cvonk/OPNhydroponics/hardware/ARCHITECTURE.md

# OPNhydroponics - Hardware Architecture

## System Overview

The **OPNhydro** project is a sophisticated **ESP32-C6 based controller** designed for a 50-plant Nutrient Film Technique (NFT) system, prioritizing chemical stability, precision dosing, and robust safety interlocks.

The architecture is built around a **24V power rail**, which was chosen specifically to accommodate a wide variety of main circulation pumps and solenoid valves.

### Reservoir and Chemical Stability
   The system centers on a **120L reservoir** (with a 100L operating level), which serves as a vital chemical and thermal buffer.
   - **PID Stability:** The 100L volume provides "chemical inertia," acting as a low-pass filter so that small doses from the pumps do not cause erratic sensor readings or "jittery" PID responses.
   - **Mixing Ratio:** The design aims for a "sweet spot" in the mixing ratio (the relationship between total volume and dose volume) to ensure sensors detect changes without causing the system to become unstable or oscillate.
   - **Rule of Thumb:** The selection of 100L for 50 plants follows the guideline of 2L of buffering per plant for leafy greens.

### Precision Dosing Strategy

For nutrient and pH management, the project utilizes ANKO A200SX stepper-based peristaltic pumps rather than standard brushed DC pumps.
   - **Precision:** Stepper motors provide highly accurate delivery (down to µL ranges), which is essential because a 100L reservoir of soft water may only require **0.2 mL of acid** to shift the pH by 0.1 points.
   - **EMI Mitigation:** To protect sensitive pH and EC probes from electrical noise (EMI) generated by the stepper drivers, the system employs a **"Silent Read"** strategy, where the motor drivers are disabled before the microcontroller requests data from the sensors.
   - **Driver Configuration:** The **Trinamic TMC2209** drivers were selected to handle the 1.7A current required by the ANKO pumps, with plans to limit current in firmware to 60–70% of the motor's rating to further reduce EMI and heat.

### Sensor Suite and Isolation

The system uses industry-grade probes to ensure long-term reliability in harsh, mineral-heavy environments.
   - **Probe Selection:** **BlueLab PROBPH** and **PROBPCEC** probes were selected for their ability to handle 24/7 immersion
. The pH probe features a **double junction**, providing a physical barrier that prevents nutrient salts from "poisoning" the internal reference wire.
   - **Ground Loop Prevention:** Because multiple probes in conductive water can distort each other's readings, the system uses **Isolated I2C** via the **ADM3260** chip. This provides a physical air gap to eliminate ground loops.
   - **Level Sensing:** A **LiDAR** sensor provides continuous depth monitoring, while **mechanical float switches** act as hardware failsafes to prevent the pump from running dry or the reservoir from overfilling   

### System Logic and Connectivity

The **ESP32-C6** was chosen for its modern connectivity options.
   - **Standalone Reliability:** While integrated with Home Assistant and (Matter/Thread in the future), the controller remains autonomous, performing daily pH corrections (specifically at 10:00 AM to avoid temperature-induced fluctuations) and EC checks every 10 minutes.
   - **Fail-Safe Design:** The Auto Top-Off (ATO) system uses a normally closed (NC) solenoid valve, ensuring the water supply shuts off if power is lost. Float switches protect the main motor from running dry, and the reservoir from overflowing.

```
┌─────────────────────────────────────────────────────────────┐
│                           24V DC INPUT                      │
│                               │                             │
│                    ┌──────────┴──────────┐                  │
│                    │                     │                  │
│                    ▼                     ▼                  │
│              ┌─────────┐           ┌─────────┐              │
│              │ 24V Bus │           │ 5V DC   │              │
│              │ (Pumps) │           │ (Logic) │              │
│              └────┬────┘           └────┬────┘              │
│                   │                     │                   │
│         ┌─────────┼─────────┐           ▼                   │
│         ▼         ▼         ▼        ┌──────────┐           │
│   ┌──────────┐ ┌──────────┐ ┌─────┐  │ 3.3V LDO │           │
│   │Main Pump │ │ Dosing   │ │ ATO │  └────┬─────┘           │
│   │ MOSFET   │ │ Stepper  │ │Valve│       │                 │
│   └──────────┘ └──────────┘ └─────┘       │                 │
│                                    ┌──────┴──────┐          │
│                                    │  ESP32-C6   │          │
│                                    │             │          │
│                                    └──────┬──────┘          │
│                                           │                 │
│         ┌─────────────┬────────────┬──────┴──────┐          │
│         │             │            │             │          │
│    ┌────┴────┐   ┌────┴────┐   ┌───┴───┐  ┌──────┴──────┐   │
│    │  I2C    │   │  GPIO   │   │ UART  │  │    RS-485   │   │
│    │  Bus    │   │         │   │       │  │   (future)  │   │
│    └────┬────┘   └────┬────┘   └───────┘  └─────────────┘   │
│         │             │                                     │
│    ┌────┴───────┐  ┌──┴─────────────┐                       │
│    │ pH EZO     │  │ LiDAR          │                       │
│    │ EC EZO     │  │ Float switches │                       │
│    │ RTD EZO    │  └────────────────┘                       │
│    └────────────┘                                           │
└─────────────────────────────────────────────────────────────┘
```

### Selected Hardware Components

The system uses industrial-grade components to ensure reliability in a continuous hydroponic environment.

Component | Selected Part | Key Reason for Selection
----------|---------------|-------------------------
Microcontroller | ESP32-C6-DevKitC-1-N8 | Integrated USB-C, PCB antenna, and support for Matter/Thread.
Main Pump | SHYSKY DC40F-2470 | 24V brushless motor, 30,000-hour lifespan, and weak acid/alkaline resistance.
Dosing Pumps | ANKO A200SX | Stepper-based for precision (µL range) and high torque.
Stepper Drivers | Trinamic TMC2209 | Supports 2.0A RMS current and offers near-silent operation.
pH Probe | BlueLab PROBPH | Double junction prevents reference poisoning; no fragile glass bulb.
EC Probe | BlueLab PROBPCEC | Easier to clean than laboratory cavity-style designs.
Temp Probe | Atlas Scientific PT-1000 | Long lifespan and direct I2C interface via EZO-RTD.
Isolation Chip | ADM3260 | Provides a physical air gap to eliminate ground loops between probes.
Reservoir Level Sensor | Benewake TF-Luna | LiDAR technology stays dry and requires no maintenance.
Float Switch | Flowline LH25-1101 | Mechanical reed switch acts as an industrial-grade hardware failsafe.
ATO Valve | DIGITEN DC 24V NC | Normally Closed (NC) design ensures it fails safe (closed) if power is lost.

## Design Decisions

Designing for a 50 leafy greens / herbs system.

A 24V rail is used because it enables a broader selection of main circulation pumps and ATO solenoid valves, which are voltage-sensitive (unlike current-regulated stepper drivers).

The controller operates independently when Home Assistant is unavailable:
- Local pH control: Once daily at 10:00 AM (avoids temperature-induced pH fluctuations)
- Doses pH Down only — pH creep is always upward; no pH Up pump fitted
- Local EC control: Doses nutrients when EC drops below threshold (every 10 min)
- Safety interlocks: Float switch protection always active
- ATO: Requires HA for user confirmation (manual override via physical button possible)
- Data logging: Buffers readings until HA reconnects

---

### 1. Main Pump Selection

Requirements:
- 400-600 L/hr for NFT (Nutrient Film Technique)
- 24V brushless motor for longlivity
- 2.5m head

#### 1.1. Parts Considered

Feature        | ✅[SHYSKY/AUBIG DC40F-2470](https://www.amazon.com/SHYSKY-DC40F-2460-Brushless-Waterproof-Submersible/dp/B0C5721V85) | [Topsflo TL-B10](https://www.topsflo.com/brushless-dc-pump/tl-b10-brushless-dc-pump.html) |
---------------|--------------|---------------------|
Voltage        | 24V DC       | 24V                 |
Current        | 1.2A         | 1.3A                |
Max Head       | 6m           | 8m                  |
Max Flow       | 960 L/hr     | 720 L/hr            |
Lifespan       | 30,000 hr    | 20,000 hr           |
Materials      | Weak acid/alkaline | FDA approved  |
Noise          | <40dB        | <40dB               |
Self-Priming   | No           | No                  |
Variable speed | PWM          | PWM                 |
Cost           | \$26         | \$30 on AliExpress  |

**✅Selected: SHYSKY/AUBIG DC40F-2470** for free shipping with Amazon Prime.

---

### 2. Main Reservoir Selection

In a Nutrient Film Technique (NFT) system, the reservoir acts as nutrient bank for the entire closed-loop operation. Since we're are building a PID-controlled system, the reservoir’s most critical function is providing chemical and thermal buffering to ensure your sensors and pumps have a stable environment to work within. 

#### 2.1. Functions of the Reservoir

- **Chemical Buffering:**: A larger reservoir volume acts as a buffer against rapid pH and EC fluctuations. For the PID loop this is vital; a small reservoir would cause "jittery" sensor readings, making it difficult for your system to learn gain without overshooting.
- **Thermal Stability:** Water has a high heat capacity, so the reservoir helps regulate the temperature of the nutrient solution. This protects roots from rapid temperature swings that could lead to stress or dissolved oxygen issues.
- **Recirculation & Filtration Point:** It serves as the collection point where gravity returns the nutrient film from the channels. This is where you place filters to prevent debris from reaching your pumps and air stones to maintain high dissolved oxygen levels.
- **Sensor Hub:** In an automated system, the reservoir is the ideal location for your pH and EC probes. It provides a "mixed" sample of the entire system's chemistry, ensuring your PID loop makes decisions based on the average state of the solution rather than localized channel data.

#### 2.2. Requirements

- **PID Stability:** A 100L+ volume provides enough chemical inertia so that a 1 mL dose from your stepper pump doesn't cause a massive pH spike. This makes your Integral (I) tuning much easier to stabilize. It acts as a Low-Pass Filter for your chemical concentrations.
- **Evapotranspiration:** On a hot day, 50 mature plants can easily drink 10–15 liters. A 100L reservoir ensures we're not refilling every 24 hours.
- **Drain-Back capacity:** In an NFT system, when the pump stops, the "film" in the channels drains back. You need roughly 15-20% extra headspace in the tank to catch this water without an overflow.
- **Light proofing:** the reservoir must be fully opaque. Any light penetration drives algae growth, which consumes nutrients, clogs the system, and destabilises pH. Black HDPE tanks or IBC totes with an opaque cover are preferred.
- **Tight fit:** use a tight-fitting lid at all times to reduces evaporation (slowing EC drift), blocks ambient light, and prevents insects, and debris from entering the solution. Keep cutouts for plumbing and sensor cables small as practical and sealed.

#### 2.3 Rule of Thumb

The **Rule of Thumb** is that Leafy greens (lettuce, herbs, kale) typically require **1.5 to 2 liters (0.5 gallons) of buffering per plant**.  Fruiting crops (tomatoes, peppers) will need about twice that. The rationale is that fruiting crops have higher and more variable water and nutrient uptake, so a larger buffer per plant is needed to prevent rapid EC and pH swings between dosing events.

Type of crop | Buffering per plant | Buffering for 50 plants
-----|-----------|--------------
Leafy greens (lettuce, herbs, kale) | 2 L/plant | 100 L
Fruiting crops (tomatoes, peppers)  | 4 L/plant | 200 L

**✅Selected: 120L Black Reservoir**, with an operating level of 100 liters, so it leaves room for drain-back. 

Metric           | Recommendation
-----------------|---------------
Total Volume     | 120 Liters (Standard heavy-duty tote size)
Operating Level  | 100 Liters (Leaves room for drain-back)
Daily Water Loss | ~10% (10 Liters/day during peak growth)
Mixing Ratio     | 100:1 (Ideal for 1mL/min to 100mL/min pump range)

#### 2.4. Mixing Ratio

The **Mixing Ratio** refers to the relationship between the total reservoir volume and the maximum volume of a single dosing event. This ratio is the "sweet spot" for ensuring that your sensors can detect a change without the system becoming chemically unstable or "oscillating".
- **High Ratio (e.g., 500:1):** Very stable, but slow to correct.
- **Low Ratio (e.g., 20:1):** Very fast, but high risk of "jitter".

---

### 3. Main Reservoir Level System

Tight water level control is less about volume and more about chemical stability.
- When **water evaporates**, it leaves behind minerals, salts, and nutrients. This can lead to osmotic shock, nutrient burn in plants. An Auto Top-Off (ATO) keeps the ratio of water-to-solids constant.
- Smaller volumes of water are more susceptible to rapid **pH swings**. Maintaining a consistent reservoir volume provides a larger "thermal and chemical mass," which acts as a buffer against rapid fluctuations caused by plant uptake or waste breakdown.
- Most pumps are not designed to **run dry**.

Requirements:
- **User confirmation**: System requests approval from user before filling
- **Timeout**: Maximum fill time prevents overflow if sensor fails
- **Safety**: Float switches provides hardware backup cutoff
- **Valve type**: 24V NC (normally closed) solenoid - fails safe (closed)
- **Hysteresis** in driving the OTA valve. If you triggered a refill the second the water dropped 1mm, your pump would "chatter" (rapidly flip on/off).

Purpose:
- A **continuous depth sensor** measure the liquid height to track consumption and guide the automatic top-off (ATO) feature
- Independent sensors for **high and low alarms** provide a safety feature in case the ATO system fails. The high alarm disables the auto top-off feature.  The low alarm disables the main pump so it can't run dry.

#### 3.1 Continuous Depth Sensor Selection

This sensors provide a real-time measurement of the liquid height, which is ideal for tracking consumption and guiding the auto top-off feature.

##### Technologies Considered

Feature  | LiDAR | Capacitive | Ultrasonic | Hydrostatic
---------|-------|------------|------------|------------
Contact | Non-contact | ❌Contact | Non-contact | ❌Contact
Precision | Very High (mm) | High (±0.2%) | Moderate (±0.25") | High (±0.1%)
Foam/Vapor | Unaffected | Unaffected | Poor | Unaffected
Blind Spot | 10 cm | 0 cm | ❌20 cm | 0 cm
Best For | Clean liquids | Viscous/Sticky fluids | General water/Chemicals | Deep tanks/Turbulence
Example Product | Benewake TF-Luna | uFire Capacitive | JSN-SR04T | DFRobot Gravity
Interface | I2C/UART | I2C | GPIO | ❌Analog
Approx. Price | \$25 – \$40 | \$35 – \$50 | \$10 – \$15 | ❌\$60 – \$80

**✅Selected: LiDAR** since it stays dry, so no maintenance-free. The 10 cm head room is acceptable since it only needs to measure the level up to the high alarm float sensor. Capacitance and hydro static were rejected since mineral buildup eventually affects these sensors.  Ultrasonic is rejected, since it needs excessive head room.

##### Parts Considered

Feature         | ST VL53L1X<sup>[1](https://www.adafruit.com/product/3967)</sup> | Benewake TF-Luna<sup>[2](https://www.robotshop.com/products/benewake-tf-luna-8m-lidar-distance-sensor)</sup> | Benewake TFmini-S<sup>[3](https://www.robotshop.com/products/benewake-tfmini-s-micro-lidar-module-i2c-12m)</sup>
----------------|------------------|------------------|------------------
Range           | 0.04-4 m         | 0.1-8 m          | 0.1-12 m
Interface       | I2C              | I2C/UART         | I2C/UART
Supply Voltage  | 2.6V – 5.5V      | 3.7V – 5.2V      | 4.5V – 6.0V
I/O Logic Level | 3.3V / 5V        | 3.3V             | 3.3V
Form Factor     | ❌Breakout board | Compact module   | Ruggedized module
Price           | $14.95           | $22.26           | ❌$48.10

**✅Selected: Benewake TF-Luna** because if its housing and price.  Rejected the ST VL53L1X since it is an unhoused breakout board.  Rejected the Benewake TFmini-S because if its price.

#### 3.2 High/Low Alarm Sensor Selection

Goals:
- A low level float switch keeps keep main pump from running dry.
- A high level float switches provides a hardware guard against both overfilling the reservoir.

Requirements
- The switches should disable the driving of the MOSFETs that control the ATO feature and main pump.
- A normally closed switch is less likely to fail.
- Horizontal side-mount, so the top of the reservoir can be opened for inspection. Also the sensing level is fixed by where you drill the hole — no float travel calculation, no ambiguity. 

##### Parts Considered

Feature                 | ✅[Flowline LH25-1101](https://www.flowline.com/product/switch-tek-lv20-lh25-mini-float-level-switch/) | [XKC-Y25-NPN](https://naylampmechatronics.com/img/cms/000435/datasheet_XKC-Y25-V.pdf) | [Gravity Digital (SEN0204)](https://mm.digikey.com/Volume0/opasdata/d220001/medias/docus/2264/SEN0204_Web.pdf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)
------------------------|--------------------------|--------------------------|--------------------------
Technology              | Mechanical Float (Reed)  | Capacitive (Non-contact) | Capacitive (Non-contact)
Material                | Polypropylene            | ABS Plastic              | ABS Plastic
Mount                   | 1/2" NPT Hole            | External Adhesive        | External Adhesive
Accuracy                | ±5mm                     | ±3mm                     | ±3mm
IP-Rating               | IP68 (Submersible)       | IP67 (Water resistant)   | IP67 (Water resistant)
Max Wall Thickness      | None                     | ~13mm                    | ~13mm
Sensitivity to Splashes | Moderate                 | ❌High                   | ❌High
Price                   | ~$40                     | ~$11                     | ~$13

**✅Selected: Flowline LH25-1101** is the "industrial" choice. Since the main reservoir is prone to splashing, a physical float is less likely to give a false positive from condensation on the tank walls. Use a stilling well (a simple piece of 2" PVC pipe with small holes at the bottom) to surround the float and keep the water surface calm

#### 3.3 Automatic Top-Off (ATO) Selection

Requirements
- 24V to match system power rail
- Normally Closed (NC), so it is fail-safe: valve closes on power loss
- 0-0.8 MPa (0-116 PSI), the typical municipal water pressure
- Brass body, EPDM/NBR seal, so it is food-safe and corrosion resistant

##### Parts Considered

Feature | ✅[DIGITEN DC 24V 1/4" NC](https://www.amazon.com/DIGITEN-Solenoid-Reverse-Osmosis-System/dp/B00X6RAHMU) | [US Solid JFSV00068](https://ussolid.com/products/u-s-solid-electric-solenoid-valve-1-4-24v-dc-solenoid-valve-stainless-steel-body-normally-closed-viton-seal-html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) | [US Solid MSV00027](https://ussolid.com/products/u-s-solid-motorized-ball-valve-1-4-stainless-steel-electrical-ball-valve-with-full-port-9-24-v-ac-dc-2-wire-auto-return-html)
----------------|-------------------------|-------------------|--------------------
Voltage         | 24V DC                  | 24V DC            | 9-24V AC/DC
Body            | Plastic                 | Stainless steel   | Stainless steel
Default state   | Normally Closed         | Normally Closed   | Normally Closed
Port            | 1/4" Quick Connect      | 1/4" NPT thread   | 1/4" NPT thread
Current         | 0.2A                    | 0.6A              | 0.2A (when moving)
Max pressure    | 0.8 MPa (116 PSI)       | 0.7 MPa (101 PSI) | 1.0 MPa (145 PSI)
Design          | Solonoid orifice        | Solonoid orifice  | Ball valve
Response time   | <1s                     | <1s               | 3-5s
Drinking safe   | Yes                     | Yes               | Yes
Cost            | \$10                    | \$30              | $25

**✅Selected: DIGITEN DC 24V 1/4" NC** for its price.

---

### 4. Dosing Pump Selection

In this NFT (Nutrient Film Technique) system, the dosing pumps act as the "precision injectors" of the system. Their primary function is to maintain a stable chemical environment.

Use a peristaltic pumps for their characteristics
- **Same volume per revolution** independent how much is left in the supply bottle. 
- **Self-priming** capability
- **Chemical resistance** (no wetted metal parts)
- **Self-sealing** when stopped (rollers pinch tube; no drip-back)

Unlike a standard water pump, a peristaltic pump is positive displacement. Whether the pH down or nutrient bottles are full or nearly empty, the pump delivers the exact same volume per revolution. This makes the "gain learning" of a  PID control algorithm much more accurate.

Requirements:
1. **Micro-Dosing pH Down**: In this recirculating NFT system, the reservoir volume is small relative to the flow. To avoid "pH Yo-yoing," the pump must deliver tiny increments of acid.
2. **Dynamic Nutrient Delivery**: When plants have "eaten" the nutrients, the EC (Electrical Conductivity) drops. The pump needs to ramp up speed to restore concentration quickly. 

#### 4.1. Requirements

Before we can explore dosing pumps, we need to know the required dosing.

In an active NFT or DWC system, pH creeps upward between doses due to two mechanisms:

1. **Plant nutrient uptake**: roots preferentially absorb nitrate (NO₃⁻) and release bicarbonate (HCO₃⁻) in exchange, alkalising the solution over hours.
2. **CO₂ offgassing**: carbonic acid (H₂CO₃) from dissolved CO₂ escapes the reservoir, removing a natural acid buffer and allowing pH to rise.

This upward drift is the dominant long-term trend in a healthy system.

##### Initial Makeup

Filling the reservoir with municipal water.

Assumptions:
- Reservoir size: 100L
- Municipal tap water at pH 7.0 to 8.5
- Nutrient: AmHydro Lettuce Nutrients, dosed at 4.0 mL/L per nutriant.
- Nutrients at pH 2.0 - 4.0
- pH Up Concentration: 25–30% Potassium Hydroxide.
- pH Down Concentration: 10% Phosphoric Acid.

**AmHydro Lettuce Nutrients** need to be mixed at 4 mL/L of water. For a 100 liter reservoir this requires 100 L × 4 mL/L = **400 mL of each nutrient**.

Concentrated nutrients are formulated to be highly acidic (pH 2.0–4.0) to keep minerals soluble. Adding 800 mL of nutrient concentrate to a 100L reservoir is a massive chemical event. The sheer volume of acid in the concentrate will likely overwhelm even the strongest hard water buffer, leading to a severe pH "crash.

Force            | Action                  | pH in soft water  | pH in hard water
-----------------|-------------------------|-------------------|--------------
Municipal water  | Fill with 100L          | 7.5               | 7.5
Nutrients added  | 400 mL of each nutrient | drop by 2.4       | drop by 1.6
**Total**        |                         | 5.1               | 5.9

##### Daily Makeup

**50 mature plants** consume 10 liters of water and their daily ration of nutrients, causing the pH to drift UP due to biological activity. A 10-liter top-off and nutrient recharge will then pull the pH back DOWN.

To maintain the mixing ratio of the nutrients, 10 L × 4 mL/L = **40 mL of each nutrient** needs to be added. 

Force            | Action                  | pH in soft water  | pH in hard water
-----------------|-------------------------|-------------------|--------------
Biological drift | 50 Plants "Eating"      | +0.4 to +0.6      | +0.1 to +0.2
Municipal Water  | 10L baseline refill     | +0.15             | +0.45
Nutrients added  | 40 mL of each nutrient  | -0.6              | -0.2
**Total**        |                         | ~**+0.1**         | ~**+0.4**

To bring the pH back down to 5.9 points:
- For **soft water**, add **0.2 mL** to **0.5 mL pH Down**
- For **hard water**, add **8 mL** to **20 mL pH Down**

#### 4.2. Requirements for a Dosing Pump

- **Precision** is essential. It needs to be able to deliver 0.1 mL pulses since a 100L reservoir of soft water may only need ~0.2 mL of acid to move the pH by 0.1.
- **Dynamic Range** should be able to handle **100 mL/min** for the initial "bulk" dosing and **1 mL/min** for fine-tuning without stalling.
- **No pH Up pump**, because besides balancing the pH after an initial fill with soft water, the pH reliably creeps upward.  A pH Up pump would fire only if pH somehow fell below target — an unusual condition that indicates a problem that needs manual investigation, not an automated correction.

#### 4.3. Technologies Considered

The table below includes EMI (Electromagnetic Interference), because the pH and EC probes are essentially high-impedance antennas. If the motor creates significant electrical noise, it can cause the sensor readings to "jitter", but also affect delicate digital parts of the system.

Feature           | Brushed DC    | ✅Stepper       | Brushless DC
------------------|---------------|-----------------|-------------
Flow Control      | ❌Inaccurate  | Highly Precise | Needs Encoder
Min. Dose         | mL range      | µL range       | mL range
EMI Noise         | High (Brush arcing) | Moderate (PWM) | Moderate
Lifespan          |❌ ~1 yr       | ~5 yr          | ~12 yr
Layout Difficulty | Low           | Moderate       | High
Price             | \$10 – \$60   | \$60 – \$170   | ❌\$150 – \$400+

A note about PCB Layout challenges:
- **Brushed DC:** While it has the worst noise, the layout is simple. The noise comes from the motor, and can be mitigated using by placing a large decoupling capacitors as close to the motor terminals as possible.
- **Stepper:** The challenge here is the high-speed switching frequency of the PWM by the driver. Requires a solid ground plane and keeping high-current motor traces short and physically isolated from the analog front-end.
- **Brushless DC:** requires a 3-phase inverter layout. Any slight imbalance in trace length or impedance can lead to timing issues and significantly higher EMI. Requires you to manage signal integrity and thermal dissipation simultaneously, making it the most complex board to design.

**✅Selected: Stepper Motor**. The Brushed DC is far to inaccurate.  The Brushed DC is very expensive. The Stepper appears to be the golden middle route.

#### 4.4. Parts Considered

Part selection for a 1–100 mL/min dosing pump in a hydroponic PID loop requires balancing mechanical torque with electrical noise isolation to protect the sensitive pH/EC sensors.

Requirements
- 24V DC motor
- I2C or UART control
- Continuous flow rate of ~5ml/min for pH down.
- Continuous flow rate of ~50 mL/min for Nutrients.

Feature       | [ANKO A200SX](https://ankoproducts.com/products/a200sx) | [Kamoer KAS-SE](https://www.kamoer.cn/us/product/detail.html?id=9005)
--------------|------------------------|-----------------------
Voltage           | 24V DC                 | 24V DC                
Technology        | Stepper motor          | Stepper motor         
Rated Current     | 1.7A (RMS)             | 0.4 – 0.8A            
Duty Cycle        | 50% (Industrial)       | Intermittent          
Acid Tubing       | Norprene               | Bioprene              
Max Flow Rate[^1] | 450 mL/min             | ❌maybe 71.5 mL/min   
Motor Life        | 5,000+ hr              | 1,000 – 2,000 hr      
Tubing Life       | ~1,000 hr              | ~1,000 hr             
Driver            | Needs ext. driver      | Needs ext. driver     
Control           | I2C to ext. driver     | I2C to ext. driver    
EMI noise         | ❌High: 1.7A switching | Moderate 0.8A switching
Price             | \$90 on ANKO Products  | \$95 on AliExpress    

[^1]: Maximum flow rate depends on the tubing installed.

Note that the **EZO-PMP is not a stepper-based**. The dependence on flow-rate calibration and the "Dose over Time" logic confirm it is a regulated DC motor using tachometer/time-based feedback rather than discrete steps. It achieves ±1% accuracy the same way a Kamoer NKP-DC-B08 would — via calibrated timed runs — not via step counting. 

Again, no clear winner.  But if we're willing to accept some limitations on how we use the ANKO stepper pump, we can have the best of both worlds.  Acceptable EMI noise and current, and the accurateness and longlivity.

Running the motor at 1A RMS (~60% of its 1.7A rating) will significantly reduce the electromagnetic field strength and current ripples that contribute to EMI. This will also reduce torque, but **40-45% less torque** will still meet the requirements.

**✅Selected: ANKO A200SX** but with the promise to implement Slient Read  (turning off motors to read sensors) and limit the motor current as far as feasible (1A ?).  Since we'll not read pH/EC while pumping, we eliminate the biggest risk of the ANKO (chopper noise). The code simply disables the motor drivers (ENN = HIGH) before requesting data from the ADM3260 islands.

---

### 5. Dosing Reservoir Level Monitoring

Monitoring the dosing reservoir (the small bottles of concentrated Nutrients and pH Down) is just as critical as monitoring your main 100L tank. In a "learning" PID system, an empty dosing bottle is a "silent killer" of your logic.

50 mature plants are "hungry." We’ll be using ~70 mL of each concentrate daily.
- A 1L bottle will last about 4 weeks.
- Without a level sensor, you have to manually check the bottles. A simple Non-contact Liquid Level Sensor on the outside of the dosing bottle can trigger an "Add Nutrients" alert to your phone before the system crashes.

For monitoring dosing reservoirs in a hydroponic system, the XKC-Y25 series is the most highly recommended non-contact liquid level sensor. These sensors use capacitive sensing technology to detect the presence of liquid through non-metallic container walls, such as plastic or glass, without direct contact.

#### 5.1. Technologies Considered

Feature          | Level Sensor       | ✅Firmware Tracking
-----------------|--------------------|------------------
User Interaction | Not required       | Tells the volume filled
Accuracy         | ±5mm               | Probably similar [^2]
Price            | ❌\$50 each        | \$0

[^2]: Peristaltic pumps have a known flow rate (mL/s), so remaining volume can be estimated by tracking cumulative dose volume in firmware. 

**✅Selected: Firmware Tracking**.  The accuracy is expected to by sufficient, and refilling only needs to be done occationally.

---

### 6. Dosing Pump Driver Selection

Requirements:
- 24V pump voltage
- 3.3V I/O voltage
- UART interface, ideally shared between drivers

#### 6.1. Parts Considered

Feature         | ✅[Trinamic TMC2209](https://www.analog.com/en/products/tmc2209.html) | [Trinamic TMC2225](https://www.analog.com/media/en/technical-documentation/data-sheets/TMC2225_datasheet_rev1.14.pdf)
----------------|---------------------|------------------|
Pump voltage    | 24V supported       | 24V supported    |
I/O voltage     | 3.3V supported      | 3.3V supported   |
Current         | 2.0A RMS max        | ❌1.4A RMS max   |
UART            | Yes (shared)        | Yes (shared)     |
Near-silent op  | StealthChop2        | StealthChop2     |
Fault detection | StallGuard4         | unknown          |

**✅Selected: Trinamic TMC2209** because the TMC2225 can't drive the 1.7A current needed for the ANKO A200SX pump.

To reduce **EMI noise and current**, choose a **target operating range of 60–70%** of the pumps rated **I<sub>RMS</sub>** .

This current should be limited in hardware and firmware:
1. Use the V<sub>REF</sub> input of the TMC2209 to set a hard limit to 90% of the 1.7 A<sub>RMS</sub> motor current. This is likely still overkill, but will limit the current further in firmware. 
2. Set `IHOLD_IRUN` register using firmware to further lower the current to a practical level Configure `IHOLD=0` (zero standstill current) via UART, so sense resistors and motor carry no current between dosing events.

#### 6.2. Nutrient A and B Channels

Two-part nutrients (Part A: calcium/iron; Part B: phosphate/sulphate) are kept separate in concentrate to prevent precipitation, but are always dosed at a 1:1 ratio in normal operation — same STEP pulse count, at the same time.

Combining both pump motors on a single TMC2209 was considered and rejected:

| Factor | Combined | ✅Separate
|---|---|---
| STEP GPIO cost | 1 GPIO pin | 2 GPIO pins
| DIR GPIO cost | n/a | n/a — DIR hardwired to 3.3V on all drivers
| BOM cost | Save ~$5 (on TMC2209) | Keep as-is
| Ratio flexibility | Locked 1:1 | Any ratio in firmware
| Tubing wear compensation | Not possible per-pump | Recalibrate each pump independently
| Fault isolation | One failure disables both | Identify which pump failed

**✅Selected: Nutrition pumps have a dedicated driver.**

**Rationale:** with stepper pumps the primary calibration concern shifts from flow-rate drift (eliminated by step counting) to tubing bore wear. Bore wear affects pump A and B at different rates depending on chemical exposure. Separate STEP channels allow independent step-count adjustment per pump without mechanical changes. The cost delta is one TMC2209 and glue (~$5). DIR is hardwired to 3.3V on all drivers — peristaltic pumps are self-sealing and never need direction reversal.

**Future field change:** if combining is ever desired, tie the two coil outputs in parallel externally and leave one TMC2209 unpopulated (DNP). No PCB revision required.

---

### 7. Probes

Highly reliable and continuous monitoring is essential for maintaining optimal pH (5.5–6.5) and EC (0.8–2.5 mS/cm) levels. pH and EC readings drift significantly as water temperature changes.

Why this is critical:
- pH Drift: pH readings change by about 0.03 pH per 1°C deviation from the 25°C calibration point.
- EC Drift: Conductivity is even more sensitive, changing by roughly 2% per 1°C. Without this link, a reservoir warming up by 5°C would report a 10% error in nutrient concentration.

To link your EZO-RTD to your pH and EC circuits, you must use a "read-then-write" loop. Atlas EZO circuits do not "talk" to each other directly on the I2C bus; your microcontroller must act as the bridge by reading the temperature and then sending it to the other sensors using `T,n` commands or `RT,n` on newer circuits.

Requirements:
- Suited continuous immersion in a mineral-heavy nutrient solution (high salts/calcium).
- Provide high accuracy and resist electrical noise from pumps.
- No need for custom analog filtering or voltage dividers.

#### 7.1. Parts Considered

##### pH Probe

Feature     | Atlas Scientific ENV-40-pH (gen3) | DFRobot pH Sensor Kit (v2) | ✅BlueLab PROBPH
------------|-------------------------------|--------------------|------------------------
Class       | Laboratory grade                | Budget-friendly    | Industry grade
Interface   | I2C/UART                        | ❌Analog           | I2C/UART
I/O voltage | 3.3 - 5V                        | 3.3 - 5.5V         | 3.3 - 5V
Range       | 0 – 14 pH                       | 0 – 14 pH          | 0 – 14 pH
Accuracy    | ±0.002 pH (ultra-high)          | ±0.1 pH (standard) | ±0.1 pH (standard)
Lifespan    | ~1-1.5 yr (double junction)     | ❌>0.5 years       | ~1.5 yr (double junction)
Maintenance | ❌Frequent cleaning/calibration | unknown            | set-and-forget
Immersion   | Indefinite                      | ❌Limited          | Indefinite
Price       | \$85 + \$46 for EZO-pH          | \$30 + ADC         | \$99 + \$46 for EZO-pH

A double junction, adds an extra physical barrier that prevents nutrient salts and heavy minerals from "poisoning" the internal reference silver wire. This makes it far superior for 24/7 immersion in "dirty" or high-EC water.

**✅Selected: BlueLab PROBPH** because no glass bulb like the Atlas, and doesn't require frequent cleaning and re-calibration. The DFRobot is engineerd for a different level of "continuous" use according to user report and needs a external ADC, as the ESP32’s native ADC is often non-linear. Note that while Bluelab states an average lifespan of 18 months for their pH probes. Many users report having to replace them more frequently in 24/7 submerged environments. 

##### EC Probe

The nutrient range typical in hydroponics is 0.8 – 2.5 mS/cm.

Feature     | Atlas Scientific EC-K1.0  | DFRobot Gravity (K=1) | ✅BlueLab PROBPCEC
------------|---------------------------|---------------------|------------------------------
Class       | Laboratory grade          | Budget-friendly     | Industry grade
Interface   | I2C/UART                  | ❌Analog            | I2C/UART
I/O voltage | 3.3 - 5V                  | 3.3 - 5.5V          | 3.3 - 5V
Range       | 0.07 – 500,000+ µS/cm     | 1 – 15,000 µS/cm    | 0 – 10,000 µS/cm
Accuracy    | ±2% of reading            | ±5% F.S.            | ±100 µS/cm at 2,770 µS/cm
Lifespan    | ~10 yr                    | >0.5 yr             | High (commercial)
Maintenance | Monthly soak              | Weekly              | Monthly scrub
Immersion   | Indefinite                | ❌Limited           | Indefinite
Price       | ❌\$140 + \$68 for EZO-EC | \$70 + external ADC | $72 + \$68 for EZO-EC

**✅Selected: BlueLab PROBPCEC** because is cheaper and easier to clean compared to the Atlas that uses a "sensing cavity design" that is hard to scrub.

##### Temperature Probe

The Bluelab Temperature Probe was included because it is the industry standard for durability in commercial hydroponic reservoirs. While the Atlas Scientific PT-1000 is more accurate for laboratory use, the Bluelab probe is favored by professional growers because its housing is specifically engineered to withstand "24/7" immersion in harsh, mineral-heavy nutrient solutions without drifting or corroding.

Feature     | ✅Atlas Scientific PT-1000 | DFRobot Gravity PT1000 | BlueLab PROBTEMP
------------|--------------------------|----------------------|-------------------------
Class       | Laboratory grade         | Industry grade       | Industry grade
Sensor type | Class A platinum RTD     | Class A platinum RTD | Thermistor / RTD Hybrid
Interface   | I2C/UART                 | ❌Analog             | ❌Analog
I/O voltage | 3.3 - 5V                 | 3.3 - 5.0V           | 3.3 - 5V
Range       | -200 - 850°C             | -30 - 350°C          | 0 - 50°C (optimized)
Accuracy    | ±(0.15 + 0.002*T)°C      | ±0.3 - 0.6°C         | ±1.0°C
Lifespan    | ~10 yr                   | >0.5 yr              | Industrial grade
Maintenance | Monthy wipe              | Periodic soak        | Set-and-forget
Immersion   | Indefinite               | ❌Limited            | Indefinite
Price       | \$24 + \$36 for EZO-RTD  | \$59 + external ADC  | \$60 + external ADC

**✅Selected: Atlas Scientific PT-1000** because it has a long lifespan and supports a I2C interface when combined with the Atlas EZO-RTD.

### 8. Probe Isolation Strategy

In a mineral-heavy reservoir, the "hidden" enemy is **ground loops** causing probe interference. Since water is conductive, multiple probes (pH, EC) in the same tank act like batteries, leaking small currents that distort each other's readings.

Note that the EZO-RTD does not require isolation; temperature measurements are resistance-based and immune to the electrical noise that affects electrochemical probes.

To prevent this, one can use the professional Isolated I2C approach or a Time Division Multiplexing (TDM) hack.

#### 8.1. Technologies considered

Feature      | ✅Isolated I2C (EZO Style)     | TDM / MOSFET Switching
-------------|--------------------------------|-----------------------
Philosophy   | Continuous, simultaneous data  | One sensor at a time (sequential)
Hardware     | I2C and DC/DC isolator         | MOSFETs + ADS1115 (16-bit ADC)
Ground Loops | Eliminated by physical air gap | Reduced, but still risky
Complexity   | Low (Plug and Play).           | High (complex wiring & timing)
Accuracy     | Highest (no interference)      | Moderate (switching noise/latency)
Cost         | ~$40–$60 for all channels      | ~$15 for all channels

**✅Selected: Isolated I2C**, because chemical probes (especially pH) require a constant charge to remain stable. Turning them off/on frequently causes "reading drift" and significantly slows down your data refresh rate.

#### 8.2. Parts considered

The Atlas Scientific ISO-I2C Brand Isolator primarily uses the ADM3260 chip from Analog Devices. Older or USB versions of their isolated carrier boards previously utilized a Silicon Labs SI8600 bidirectional I2C isolator and an RFM-0505 or Mornsun B0505S isolated DC-DC converter. 

Feature    | ✅ADM3260        | Atlas ISO-I2C Board | uFire / DFRobot Isolators
-----------|------------------|---------------------|--------------------------
Footprint  | IC and glue      | Mezzanine board     | Mezzanine board
Difficulty | Layout sensitive | Plug & play         | Plug & play
Price      | \$8 per channel  | ❌\$32 per channel  | \$20 per channel

**✅Selected: ADM3260**

---

### 9. Microcontroller Selection

To manage the hydroponic system with high-precision probes and dosing pumps, your microcontroller needs to handle multiple communication protocols simultaneously while maintaining timing for dosing.

#### 9.1. Requirements

1. **Communication Protocols**
   - I2C Bus: Required for Atlas Scientific EZO circuits (pH, EC, Temp).
   - UART: Required for TMC2209/TMC2225 drivers.
   - GPIO: Need 1 step pin per dpsing pump, 2 for water level sensors, 2 for float switches.

2. **Processing and Memory**
   - Dual-Core Architecture: The ESP32 is ideal because you can run the Dosing Logic/Stepper timing on Core 1 and the Wi-Fi/Data Logging/Web Server on Core 0. This prevents "jitter" in the stepper motors when the device sends data to the cloud.
   - Non-Volatile Memory: Essential for storing calibration data for your pH/EC probes and your "steps-per-ml" pump values so they aren't lost during power outages.

3. **Power and Logic Levels**
   - 3.3V Logic: The ESP32 operates at 3.3V.
   - ADC Resolution: If you bypass Atlas Scientific and use analog sensors, you need a 12-bit or 16-bit ADC. The ESP32's internal ADC is 12-bit but notoriously non-linear; an external ADS1115 (16-bit) is highly recommended for stable analog readings.

4. **Connectivity Requirements**
   - WiFi: Enables push alerts to a dashboard (like Home Assistant, Blynk, or Grafana) via MQTT or HTTP.
   - Matter/Thread: be ready for the future of home automation.

#### 9.2. Parts Considered

Feature | [ESP32-C6-WROOM-1-N8](https://documentation.espressif.com/esp32-c6-wroom-1_wroom-1u_datasheet_en.pdf) | ✅[ESP32-C6-DevKitC-1-N8](https://docs.espressif.com/projects/esp-dev-kits/en/latest/esp32c6/esp32-c6-devkitc-1/index.html)
----------------|-------------------|----------------------
Core SoC        | ESP32-C6 (RISC-V @ 160MHz) | ESP32-C6 (RISC-V @ 160MHz)
Form Factor     | Surface Mount              | Pin Headers
USB Interface   | ❌None                     | Dual USB-C (UART & Native USB)
Power Input     | 3.0V – 3.6V                | 5V (USB) or 3.3V/5V (Pins)
Onboard I/O     | 28 GPIOs                   | 20 GPIOs
Flash Memory    | 8MB                        | 8MB
Antenna         | ❌Requires trace antenna   | On-board
Voltage Control | External LDO required      | Built-in 3.3V Regulator
Price           | \$9                        | \$11

The ESP32 (WROOM or WROVER modules) is the industry standard for this scale.

**✅Selected: ESP32-C6-DevKitC-1-N8**, the integrated USB-C port, PCB antenna and RGB LED simplify the PCB design. Well worth the price difference.

---

## Power Architecture

### 1. Supply Selection

A single 24V rail powers all actuators (pumps, ATO valve) and steps down to 5V and 3.3V for logic and sensors. 24V is chosen to match the main pump, dosing pumps, and ATO solenoid valve — all voltage-sensitive loads.

**✅Selected: Mean Well LRS-150-24** (24V / 6.5A / 150W, enclosed metal, convection cooled) — recommended for comfortable headroom.

**Minimum: LRS-100-24** (24V / 4.2A / 100W) if cost is a priority.

**IP67 wet-environment alternative:** LPV-100-24 (24V / 4.2A / 100W). Avoid HDR-60-24 — only 2.5A, insufficient.

### 2. Power Rail Diagram

```
24V DC Input (Mean Well LRS-150-24, 6.5A)
    │
    ├──► 24V Rail ──┬──► SHYSKY DC40F-2470 Main Pump  (Q1, IRLR2905 MOSFET)
    │               ├──► TMC2209 #1 — ANKO A200SX pH Down
    │               ├──► TMC2209 #2 — ANKO A200SX Nutrient A
    │               ├──► TMC2209 #3 — ANKO A200SX Nutrient B
    │               └──► DIGITEN ATO Solenoid Valve     (Q8, AO3400A MOSFET)
    │
    └──► TPS62933 Buck Converter ──► 5V @ 3A
                                        ├──► Benewake TF-Luna LiDAR
                                        └──► AMS1117-3.3 LDO ──► 3.3V @ 1A
                                                                      ├──► ESP32-C6
                                                                      ├──► RTD EZO circuit
                                                                      ├──► BME280
                                                                      ├──► BH1750
                                                                      ├──► OLED Display
                                                                      ├──► ADM3260 #1 (pH isolator)
                                                                      │       └──► pH EZO (isolated 3.3V via isoPower)
                                                                      └──► ADM3260 #2 (EC isolator)
                                                                              └──► EC EZO (isolated 3.3V via isoPower)
```

Note: TPS62933 input range 3.8–30V — 24V is within spec. The AMS1117 is a linear regulator; its input current equals its output current, so the 3.3V load is fully reflected on the 5V rail.

### 3. Power Budget

The EZO-pH and EZO-EC circuits are powered via ADM3260 isoPower on an isolated 3.3V rail. They do not draw directly from the main 3.3V bus — that current is accounted for in the ADM3260 host-side column below (at ~65% DC/DC efficiency).

#### 3.3V Logic Rail Budget

This rail is powered by an AMS1117 linear regulator (rated for 1A). Note that the isolated pH and EC circuits are powered through the ADM3260 chips, which draw their host-side current from this rail.

Component           | Typ Current | Max Current | Notes
--------------------|-------------|-------------|------
EZO-pH + Isolator   |       37 mA |       60 mA | Includes isoPower to EZO-pH
EZO-EC + Isolator   |       42 mA |       62 mA | Includes isoPower to EZO-EC
EZO-RTD             |       15 mA |       16 mA | No isolation required
BME280              |        1 mA |        3 mA | Environmental sensor
BH1750              |      0.2 mA |        1 mA | Light sensor
**3.3V Rail Total** |       ~? mA |       ~? mA |

Regulator: AMS1117 (1A Rated)

#### 5V Peripheral Rail Budget

This rail is managed by a TPS62933 switching regulator (rated for 3A). Because the 3.3V regulator is linear, the entire 3.3V load is reflected directly onto this 5V rail

Component             | Typ Current | Max Current | Notes
----------------------|-------------|-------------|------
ESP32-C6-DEVKITC-1    |       70 mA |      380 mA | Peak with WiFi active
TF-Luna LiDAR         |       70 mA |      150 mA | Continuous level sensing
5V Direct Load Total  |       ~? mA |       ~? mA | Excluding reflected logic load
**Full 5V Rail Load** |       ~? mA |       ~? mA | Including 3.3V reflected chain

#### 24V Main Power Rail Budget (Actuators)

Component                   | Typ Current | Max Current | Notes
----------------------------|-------------|-------------|------
SHYSKY DC40F-2470 Main Pump |    1,200 mA |    1,200 mA | Main circulation
ANKO A200SX (pH Down)       |    1,000 mA |    1,530 mA | EN disabled when idle
ANKO A200SX (Nutrient A)    |    1,000 mA |    1,530 mA | EN disabled when idle
ANKO A200SX (Nutrient B)    |    1,000 mA |    1,530 mA | EN disabled when idle
DIGITEN ATO Solenoid Valve  |      200 mA |      200 mA | Energized only during fill
**24V Rail Total**          |       ~? mA |       ~? mA | Max 2 steppers[^3]

[^3]: Per the dosing sequence, nutrients and pH Down never step simultaneously. Normal worst-case is main pump running with both nutrient dosing pumps active:

## PCB Design Requirements

### Board Specifications
- Size: 100mm × 80mm (fits common enclosures)
- Layers: 4-layer for EMI
- Copper: 2oz outer layers (for power traces)
- Finish: HASL or ENIG

### Protection Features
- Fused inputs
- Reverse polarity protection (P-MOSFET)
- Overvoltage protection (TVS diodes)
- ESD protection on all external connections

### EMC Considerations
- Keep analog traces away from switching supplies
- Ground plane under ESP32-C6 antenna keep-out
- Decoupling capacitors close to ICs
- Ferrite beads on power inputs

## Enclosure

Recommended: IP65 rated ABS enclosure, ~150×100×70mm
- Cable glands for all wiring
- Panel-mount BNC connectors for pH/EC/RTD probes (3×)
- Optional: Clear lid for status LED visibility
