cvonk/OPNhydroponics/hardware/OPNhydro_r1/OPNhydro_r1.kicad_sch

## KiCad design hardware/OPNhydro_r1/OPNhydro_r1.kicad_sch (2026-03-04)

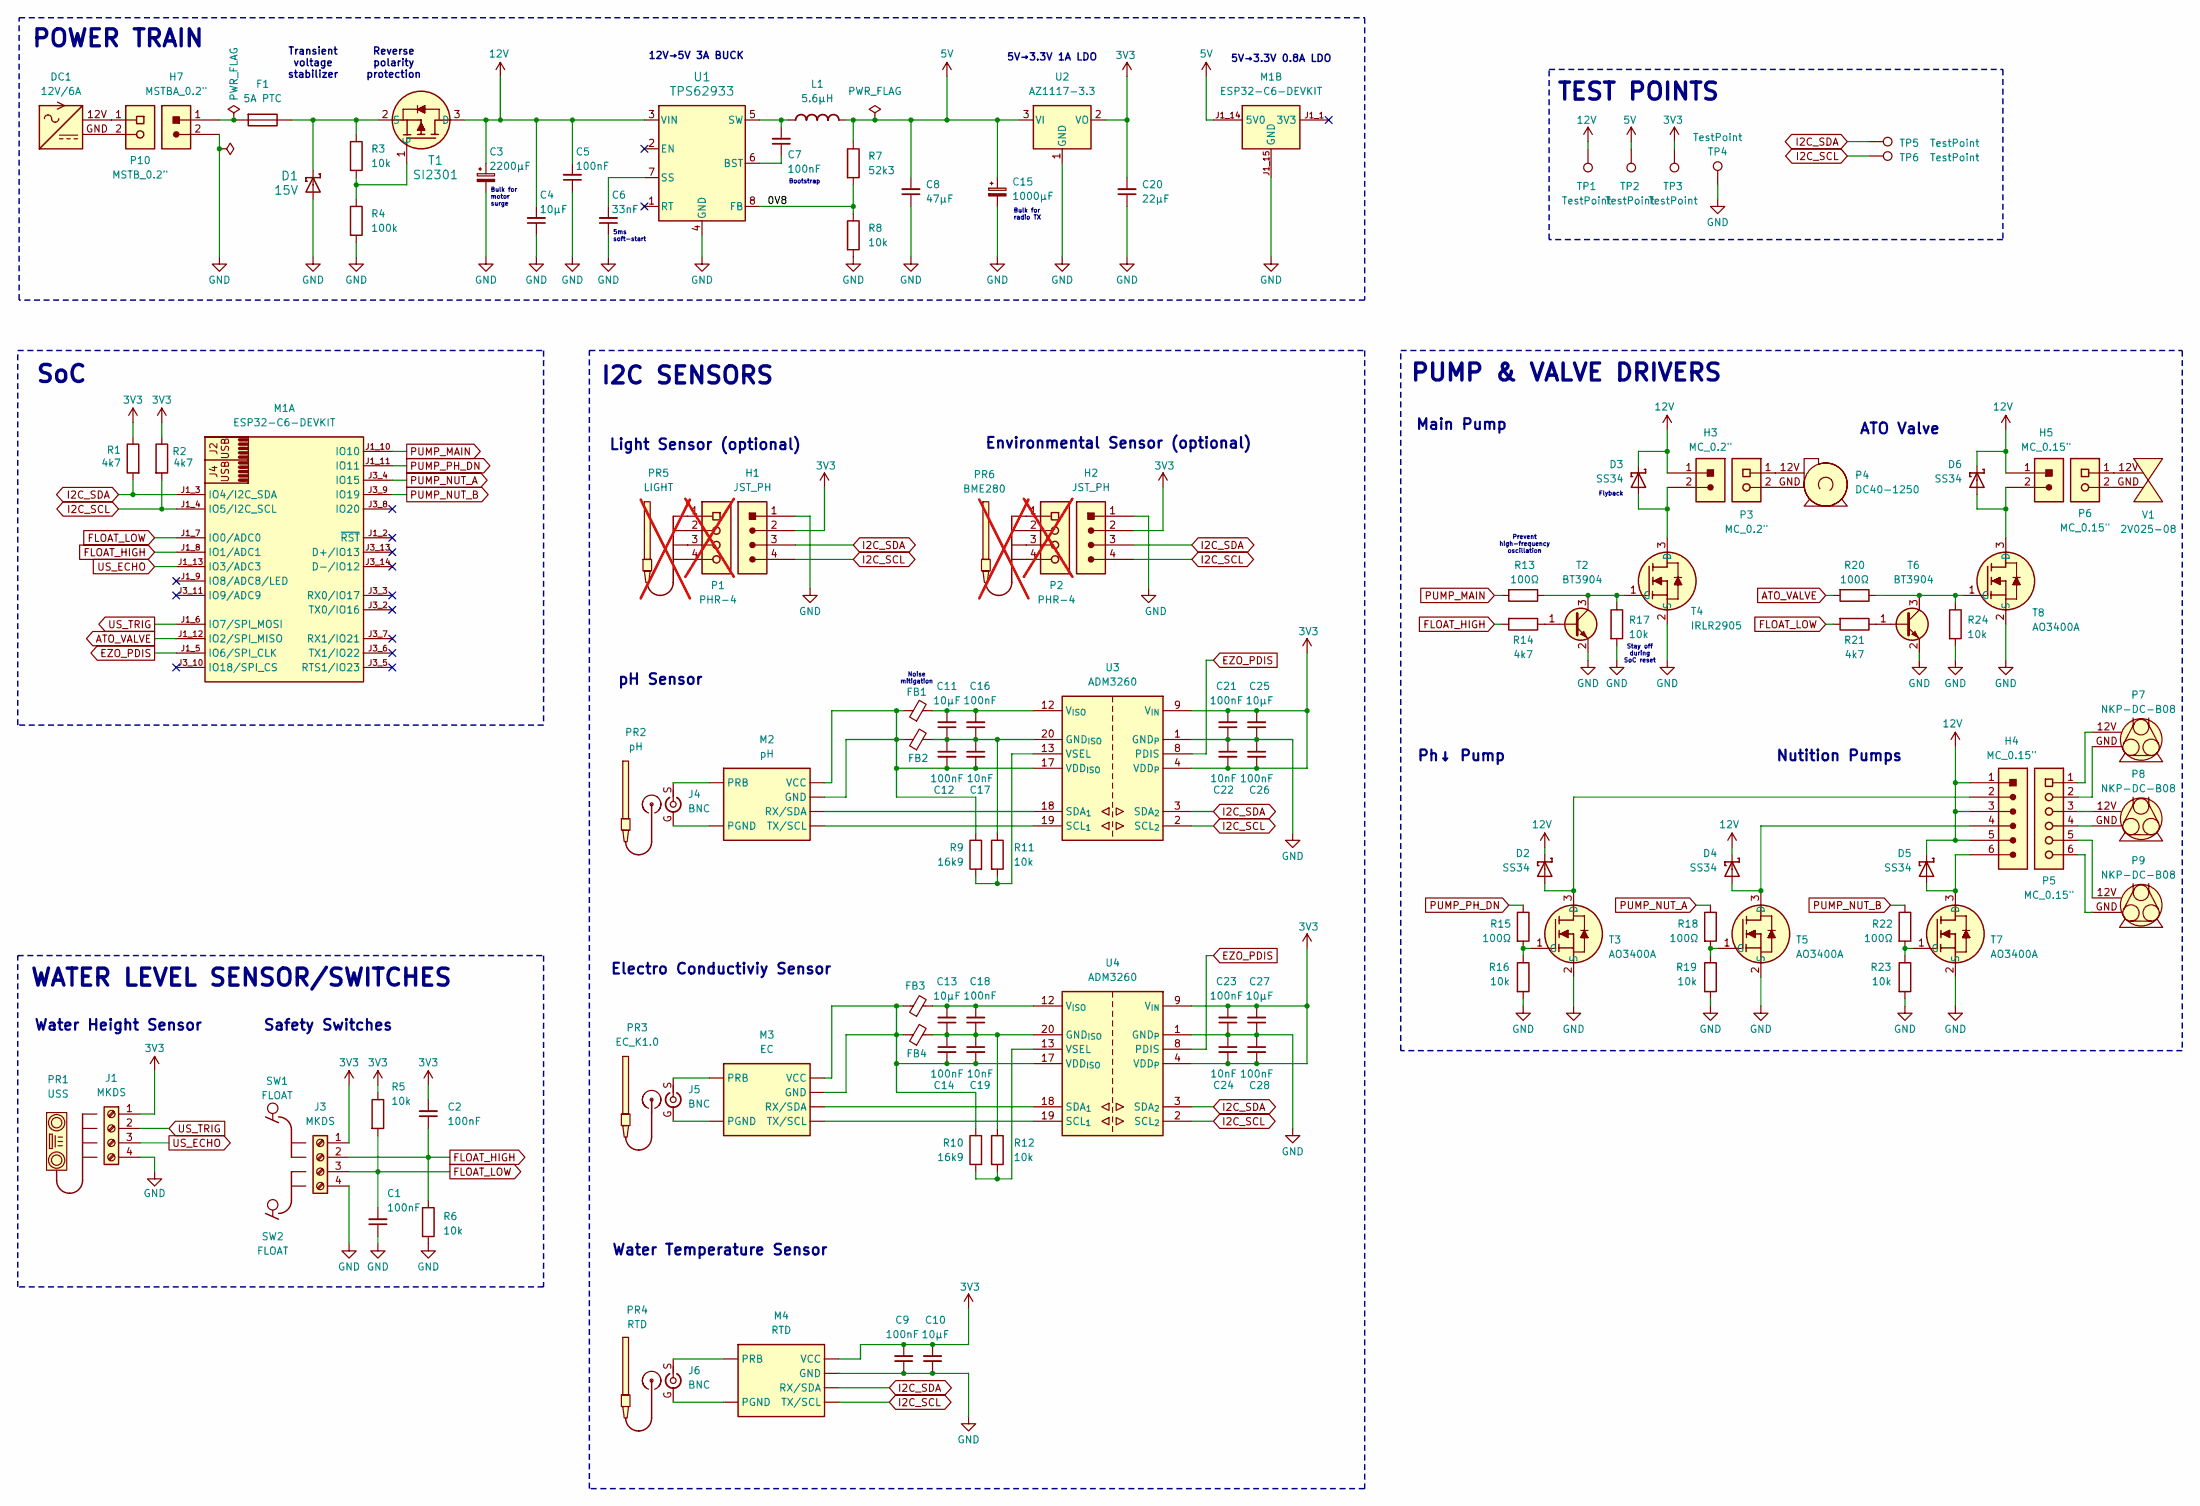
[picture p1: schematic OPNhydro_r1.kicad_sch]

Parts:
C1, C2, C5, C7, C9, C12, C14, C16, C18, C21, C23, C26, C28: 100nF; CAP X7R 100nF ±10 25V 0805
C3: 2200μF; CAP ALUM 2200μF ±20 25V RADIAL
C4, C10, C11, C13, C25, C27: 10μF; CAP X7R 10μF ±10 16V 0805
C6: 33nF; CAP X7R 33nF ±10 25V 0805
C8: 47μF; CAP X5R 47μF ±10 10V 1206
C15: 1000μF; CAP ALUM 1000μF ±20 10V
C17, C19, C22, C24: 10nF; CAP X7R 10nF ±10% 50V 0805
C20: 22μF; CAP X7R 22μF ±10 10V 1206
D1: 15V; DIODE TVS 15VWM 24.4VC SMBJ15A DO214AA
D2, D3, D4, D5, D6: SS34; DIODE SCHOTTKY 40V 3A DIOM7959X265N DO214AB
DC1: 12V/6A
F1: 5A PTC; FUSE RKEF500 PTC 60V 5A
FB1, FB2, FB3, FB4: 330Ω at 100MHz; FERRITE BEAD 330Ω 0805
H1, H2: JST_PH; HEADER MALE 4POS 2mm JST-PA
H3: MC_0.2"; TERM BLK HDR 2POS 5.08mm
H4: MC_0.15"; TERM BLK HDR 6POS 3.81mm
H5: MC_0.15"; TERM BLK HDR 2POS 3.81mm
H7: MSTBA_0.2"; TERM BLK HDR 2POS MSTBA 5.08mm
J1, J3: MKDS; TERM BLK 4POS SCREW 3.5mm
J4, J5, J6: BNC; CONN BNC JACK RA 50Ω; PARTREV B3
L1: 5.6µH; IND 5.6µH 3.5A 40mΩ
M1: ESP32-C6-DEVKIT; EVAL ESP32-C6-DEVKITC
M2: pH; MEZZ EZO pH
M3: EC; MEZZ EZO EC
M4: RTD; MEZZ EZO RTD
P1, P2: PHR-4; not fitted
P3: MC_0.2"; TERM BLK PLUG 2POS 5.08mm
P4: DC40-1250
P5: MC_0.15"; TERM BLK PLUG 6POS 3.81mm
P6: MC_0.15"; TERM BLOCK PLUG 2POS 3.81mm 1803578
P7, P8, P9: NKP-DC-B08
P10: MSTB_0.2"; TERM BLK PLG 2POS MSTB 5.08mm
PR1: USS
PR2: pH
PR3: EC_K1.0
PR4: RTD
PR5: LIGHT; not fitted
PR6: BME280; not fitted
R1, R2, R14, R21: 4k7; RES 4.7kΩ ±1 18W Yageo 0805
R3, R5, R6, R8, R11, R12, R16, R17, R19, R23, R24: 10k; RES 10kΩ ±1 18W Yageo 0805
R4: 100k; RES 100kΩ 0805
R7: 52k3; RES 52.3kΩ 0805
R9, R10: 16k9; RES 16.9kΩ ±1 18W 0805
R13, R15, R18, R20, R22: 100Ω; RES 100Ω ±1 18W Yageo 0805
SW1, SW2: FLOAT
T1: SI2301; MOSFET P-CH 20V 3.1A SI2301CDS SOT23-3
T2, T6: BT3904; TRANS NPN 40V 0.2A SOT23-3
T3, T5, T7, T8: AO3400A; MOSFET N-CH 30V 5.7A AO3400A SOT23-3L
T4: IRLR2905; MOSFET N-CH 55V 42A IRLR2905TRPBF DPAK
TP1, TP2, TP3, TP4, TP5, TP6: TestPoint; TestPoint_Pad_1.0x1.0mm
U1: TPS62933; REG ADJ 3A BUCK TPS62933 SOT583
U2: AZ1117-3.3; REG 3.3V 1A LDO AZ1117-3.3
U3, U4: ADM3260; IC ISOLTR 2.5KV 2CH I2C 20SSOP ADM3260
V1: 2V025-08

Connections:
0V8: R7.1, R8.2, U1.8 (FB)
3V3: C2.2, C9.2, C10.2, C20.2, C21.2, C22.2, C23.2, C24.2, C25.2, C26.2, C27.2, C28.2, H1.2 (3V3), H2.2 (3V3), J1.1, J3.1, M4.6 (VCC), R1.2, R2.2, R5.2, TP3.1, U2.2 (VO), U3.4 (VDD_{P}), U3.9 (V_{IN}), U4.4 (VDD_{P}), U4.9 (V_{IN})
5V: C8.2, C15.1, L1.2, M1.J1_14 (5V0), R7.2, TP2.1, U2.3 (VI)
12V: C3.1, C4.2, C5.2, D2.C, D3.C, D4.C, D5.C, D6.C, H3.1, H4.1, H4.3, H4.5, H5.1, T1.3 (D), TP1.1, U1.3 (VIN)
ATO_VALVE: M1.J1_12 (IO2/SPI_MISO), R20.1
EZO_PDIS: M1.J1_5 (IO6/SPI_CLK), U3.8 (PDIS), U4.8 (PDIS)
FLOAT_HIGH: C2.1, J3.2, M1.J1_8 (IO1/ADC1), R6.2, R14.1
FLOAT_LOW: C1.2, J3.3, M1.J1_7 (IO0/ADC0), R5.1, R21.1
GND: C1.1, C3.2, C4.1, C5.1, C6.1, C8.1, C9.1, C10.1, C15.2, C20.1, C21.1, C22.1, C23.1, C24.1, C25.1, C26.1, C27.1, C28.1, D1.2 (A), H1.1 (GND), H2.1 (GND), H7.2, J1.4, J3.4, M1.J1_15 (GND), M1.J3_1 (GND), M1.J3_12 (GND), M1.J3_15 (GND), M4.1 (GND), R4.1, R6.1, R8.1, R16.1, R17.1, R19.1, R23.1, R24.1, T2.2 (E), T3.2 (S), T4.2 (S), T5.2 (S), T6.2 (E), T7.2 (S), T8.2 (S), TP4.1, U1.4 (GND), U2.1 (GND), U3.1 (GND_{P}), U3.5 (GND_{P}), U3.7 (GND_{P}), U3.10 (GND_{P}), U4.1 (GND_{P}), U4.5 (GND_{P}), U4.7 (GND_{P}), U4.10 (GND_{P})
I2C_SCL: H1.4 (I2C_SCL), H2.4 (I2C_SCL), M1.J1_4 (IO5/I2C_SCL), M4.2 (TX/SCL), R2.1, TP6.1, U3.2 (SCL_{2}), U4.2 (SCL_{2})
I2C_SDA: H1.3 (I2C_SDA), H2.3 (I2C_SDA), M1.J1_3 (IO4/I2C_SDA), M4.3 (RX/SDA), R1.1, TP5.1, U3.3 (SDA_{2}), U4.3 (SDA_{2})
unnamed: C6.2, U1.7 (SS)
unnamed: C7.1, U1.6 (BST)
unnamed: C7.2, L1.1, U1.5 (SW)
unnamed: C11.1, C12.1, C16.1, C17.1, FB2.2, R11.2, U3.11 (GND_{ISO}), U3.14 (GND_{ISO}), U3.16 (GND_{ISO}), U3.20 (GND_{ISO})
unnamed: C11.2, C16.2, FB1.2, U3.12 (V_{ISO})
unnamed: C12.2, C17.2, FB1.1, FB2.1, M2.1 (GND), M2.6 (VCC), R9.2, U3.17 (VDD_{ISO})
unnamed: C13.1, C14.1, C18.1, C19.1, FB4.2, R12.2, U4.11 (GND_{ISO}), U4.14 (GND_{ISO}), U4.16 (GND_{ISO}), U4.20 (GND_{ISO})
unnamed: C13.2, C18.2, FB3.2, U4.12 (V_{ISO})
unnamed: C14.2, C19.2, FB3.1, FB4.1, M3.1 (GND), M3.6 (VCC), R10.2, U4.17 (VDD_{ISO})
unnamed: D1.1 (C), F1.2, R3.2, T1.2 (S)
unnamed: D2.A, H4.2, T3.3 (D)
unnamed: D3.A, H3.2, T4.3 (D)
unnamed: D4.A, H4.4, T5.3 (D)
unnamed: D5.A, H4.6, T7.3 (D)
unnamed: D6.A, H5.2, T8.3 (D)
unnamed: DC1.12V, P10.1
unnamed: DC1.GND, P10.2
unnamed: F1.1, H7.1
unnamed: J4.G (GND), M2.4 (PGND)
unnamed: J4.S, M2.5 (PRB)
unnamed: J5.G (GND), M3.4 (PGND)
unnamed: J5.S, M3.5 (PRB)
unnamed: J6.G (GND), M4.4 (PGND)
unnamed: J6.S, M4.5 (PRB)
unnamed: M2.2 (TX/SCL), U3.19 (SCL_{1})
unnamed: M2.3 (RX/SDA), U3.18 (SDA_{1})
unnamed: M3.2 (TX/SCL), U4.19 (SCL_{1})
unnamed: M3.3 (RX/SDA), U4.18 (SDA_{1})
unnamed: P1.1, PR5.1
unnamed: P1.2, PR5.2
unnamed: P1.3, PR5.3
unnamed: P1.4, PR5.4
unnamed: P2.1, PR6.1
unnamed: P2.2, PR6.2
unnamed: P2.3, PR6.3
unnamed: P2.4, PR6.4
unnamed: P3.1, P4.12V
unnamed: P3.2, P4.GND
unnamed: P5.1, P7.12V
unnamed: P5.2, P7.GND
unnamed: P5.3, P8.12V
unnamed: P5.4, P8.GND
unnamed: P5.5, P9.12V
unnamed: P5.6, P9.GND
unnamed: P6.1, V1.12V
unnamed: P6.2, V1.GND
unnamed: PR3.G, PR3.S
unnamed: R3.1, R4.2, T1.1 (G)
unnamed: R10.1, R12.1, U4.13 (VSEL)
unnamed: R9.1, R11.1, U3.13 (VSEL)
unnamed: R13.2, R17.2, T2.3 (C), T4.1 (G)
unnamed: R14.2, T2.1 (B)
unnamed: R15.1, R16.2, T3.1 (G)
unnamed: R18.1, R19.2, T5.1 (G)
unnamed: R20.2, R24.2, T6.3 (C), T8.1 (G)
unnamed: R21.2, T6.1 (B)
unnamed: R22.1, R23.2, T7.1 (G)
PUMP_MAIN: M1.J1_10 (IO10), R13.1
PUMP_NUT_A: M1.J3_4 (IO15), R18.2
PUMP_NUT_B: M1.J3_9 (IO19), R22.2
PUMP_PH_DN: M1.J1_11 (IO11), R15.2
US_ECHO: J1.3, M1.J1_13 (IO3/ADC3)
US_TRIG: J1.2, M1.J1_6 (IO7/SPI_MOSI)

Notes on the sheet:
pH Sensor
5V→3.3V 1A LDO
Safety Switches
Nutition Pumps
Bulk for radio TX
POWER TRAIN
Stay off during SoC reset
Reverse polarity protection
Water Temperature Sensor
Electro Conductiviy Sensor
Bootstrap
5V→3.3V 0.8A LDO
Environmental Sensor (optional)
5ms soft-start
Transient voltage stabilizer
12V→5V 3A BUCK
SoC
I2C SENSORS
PUMP & VALVE DRIVERS
TEST POINTS
Bulk for motor surge
Light Sensor (optional)
Ph↓ Pump
ATO Valve
WATER LEVEL SENSOR/SWITCHES
Prevent high-frequency oscillation
Noise mitigation
Main Pump
Water Height Sensor
Flyback
