cvonk/OPNhydroponics/hardware/OPNhydro_r2/OPNhydro_r2.kicad_sch

## KiCad design hardware/OPNhydro_r2/OPNhydro_r2.kicad_sch (2026-03-04, an earlier design)

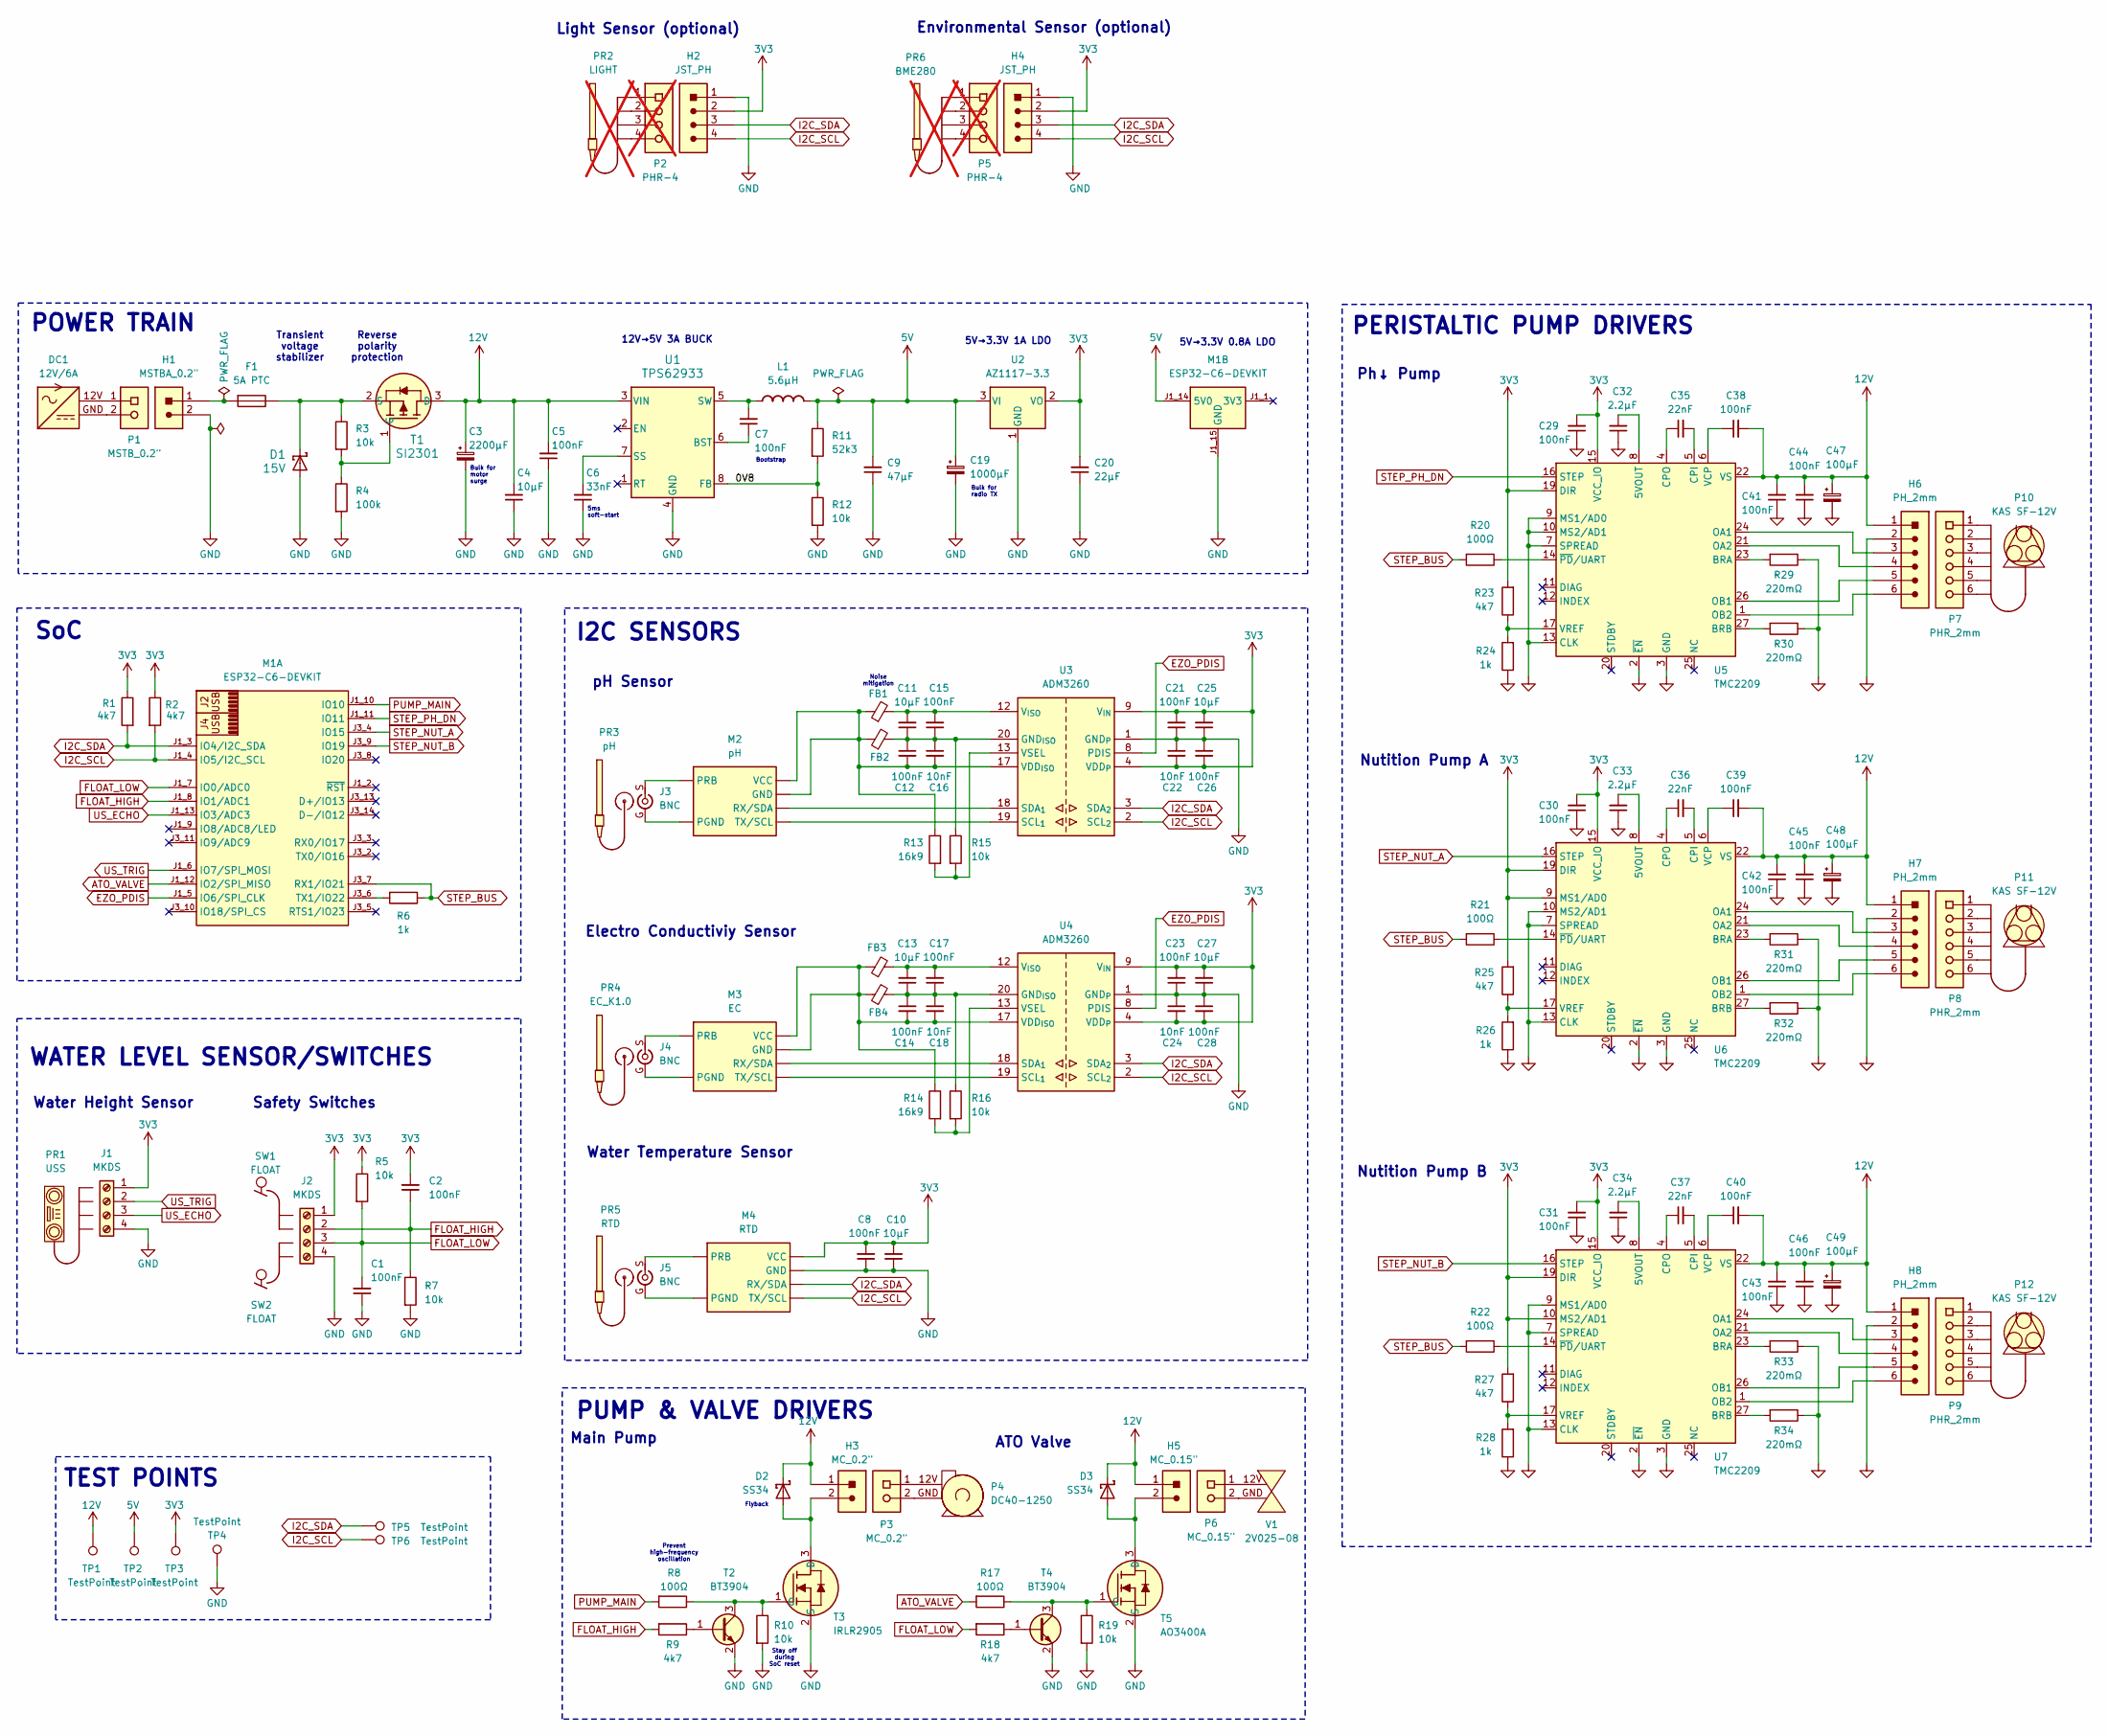
[picture p2: schematic OPNhydro_r2.kicad_sch]

Parts:
C1, C2, C5, C7, C8, C12, C14, C15, C17, C21, C23, C26, C28, C29, C30, C31, C38, C39, C40, C41, C42, C43, C44, C45, C46: 100nF; CAP X7R 100nF ±10 25V 0805
C3: 2200μF; CAP ALUM 2200μF ±20 25V RADIAL
C4, C10, C11, C13, C25, C27: 10μF; CAP X7R 10μF ±10 16V 0805
C6: 33nF; CAP X7R 33nF ±10 25V 0805
C9: 47μF; CAP X5R 47μF ±10 10V 1206
C16, C18, C22, C24: 10nF; CAP X7R 10nF ±10% 50V 0805
C19: 1000μF; CAP ALUM 1000μF ±20 10V
C20: 22μF; CAP X7R 22μF ±10 10V 1206
C32, C33, C34: 2.2μF; CAP X7R 2.2μF ±10 10V
C35, C36, C37: 22nF; CAP X7R 22nF ±10 50V 0805
C47, C48, C49: 100μF; CAP ALUM 100μF ±20 25V
D1: 15V; DIODE TVS 15VWM 24.4VC SMBJ15A DO214AA
D2, D3: SS34; DIODE SCHOTTKY 40V 3A DIOM7959X265N DO214AB
DC1: 12V/6A
F1: 5A PTC; FUSE RKEF500 PTC 60V 5A
FB1, FB2, FB3, FB4: 330Ω at 100MHz; FERRITE BEAD 330Ω 0805
H1: MSTBA_0.2"; TERM BLK HDR 2POS MSTBA 5.08mm
H2, H4: JST_PH; HEADER MALE 4POS 2mm JST-PA
H3: MC_0.2"; TERM BLK HDR 2POS 5.08mm
H5: MC_0.15"; TERM BLK HDR 2POS 3.81mm
H6, H7, H8: PH_2mm; TERM BLK HDR 6POS PH 2mm
J1, J2: MKDS; TERM BLK 4POS SCREW 3.5mm
J3, J4, J5: BNC; CONN BNC JACK RA 50Ω; PARTREV B3
L1: 5.6µH; IND 5.6µH 3.5A 40mΩ
M1: ESP32-C6-DEVKIT; EVAL ESP32-C6-DEVKITC
M2: pH; MEZZ EZO pH
M3: EC; MEZZ EZO EC
M4: RTD; MEZZ EZO RTD
P1: MSTB_0.2"; TERM BLK PLG 2POS MSTB 5.08mm
P2, P5: PHR-4; not fitted
P3: MC_0.2"; TERM BLK PLUG 2POS 5.08mm
P4: DC40-1250
P6: MC_0.15"; TERM BLOCK PLUG 2POS 3.81mm 1803578
P7, P8, P9: PHR_2mm; TERM BLK PLG 6POS PHR 2mm
P10, P11, P12: KAS SF-12V
PR1: USS
PR2: LIGHT; not fitted
PR3: pH
PR4: EC_K1.0
PR5: RTD
PR6: BME280; not fitted
R1, R2, R9, R18, R23, R25, R27: 4k7; RES 4.7kΩ ±1 18W Yageo 0805
R3, R5, R7, R10, R12, R15, R16, R19: 10k; RES 10kΩ ±1 18W Yageo 0805
R4: 100k; RES 100kΩ 0805
R6, R24, R26, R28: 1k; RES 1kΩ ±1 18W Yageo 0805
R8, R17, R20, R21, R22: 100Ω; RES 100Ω ±1 18W Yageo 0805
R11: 52k3; RES 52.3kΩ 0805
R13, R14: 16k9; RES 16.9kΩ ±1 18W 0805
R29, R30, R31, R32, R33, R34: 220mΩ; RES 220mΩ ±1 18W Yageo 0805
SW1, SW2: FLOAT
T1: SI2301; MOSFET P-CH 20V 3.1A SI2301CDS SOT23-3
T2, T4: BT3904; TRANS NPN 40V 0.2A SOT23-3
T3: IRLR2905; MOSFET N-CH 55V 42A IRLR2905TRPBF DPAK
T5: AO3400A; MOSFET N-CH 30V 5.7A AO3400A SOT23-3L
TP1, TP2, TP3, TP4, TP5, TP6: TestPoint; TestPoint_Pad_1.0x1.0mm
U1: TPS62933; REG ADJ 3A BUCK TPS62933 SOT583
U2: AZ1117-3.3; REG 3.3V 1A LDO AZ1117-3.3
U3, U4: ADM3260; IC ISOLTR 2.5KV 2CH I2C 20SSOP ADM3260
U5, U6, U7: TMC2209; IC STEP MOTOR DRIVER TMC2209-LA-T
V1: 2V025-08

Connections:
0V8: R11.1, R12.2, U1.8 (FB)
3V3: C2.2, C8.2, C10.2, C20.2, C21.2, C22.2, C23.2, C24.2, C25.2, C26.2, C27.2, C28.2, C29.2, C30.2, C31.2, H2.2 (3V3), H4.2 (3V3), J1.1, J2.1, M4.6 (VCC), R1.2, R2.2, R5.2, R23.1, R25.1, R27.1, TP3.1, U2.2 (VO), U3.4 (VDD_{P}), U3.9 (V_{IN}), U4.4 (VDD_{P}), U4.9 (V_{IN}), U5.15 (VCC_IO), U5.19 (DIR), U6.9 (MS1/AD0), U6.15 (VCC_IO), U6.19 (DIR), U7.10 (MS2/AD1), U7.15 (VCC_IO), U7.19 (DIR)
5V: C9.2, C19.1, L1.2, M1.J1_14 (5V0), R11.2, TP2.1, U2.3 (VI)
12V: C3.1, C4.2, C5.2, C38.2, C39.2, C40.2, C41.2, C42.2, C43.2, C44.2, C45.2, C46.2, C47.1, C48.1, C49.1, D2.C, D3.C, H3.1, H5.1, H6.1, H7.1, H8.1, T1.3 (D), TP1.1, U1.3 (VIN), U5.22 (VS), U5.28 (VS), U6.22 (VS), U6.28 (VS), U7.22 (VS), U7.28 (VS)
ATO_VALVE: M1.J1_12 (IO2/SPI_MISO), R17.1
EZO_PDIS: M1.J1_5 (IO6/SPI_CLK), U3.8 (PDIS), U4.8 (PDIS)
FLOAT_HIGH: C2.1, J2.2, M1.J1_8 (IO1/ADC1), R7.2, R9.1
FLOAT_LOW: C1.2, J2.3, M1.J1_7 (IO0/ADC0), R5.1, R18.1
GND: C1.1, C3.2, C4.1, C5.1, C6.1, C8.1, C9.1, C10.1, C19.2, C20.1, C21.1, C22.1, C23.1, C24.1, C25.1, C26.1, C27.1, C28.1, C29.1, C30.1, C31.1, C32.1, C33.1, C34.1, C41.1, C42.1, C43.1, C44.1, C45.1, C46.1, C47.2, C48.2, C49.2, D1.2 (A), H1.2, H2.1 (GND), H4.1 (GND), H6.2, H7.2, H8.2, J1.4, J2.4, M1.J1_15 (GND), M1.J3_1 (GND), M1.J3_12 (GND), M1.J3_15 (GND), M4.1 (GND), R4.1, R7.1, R10.1, R12.1, R19.1, R24.2, R26.2, R28.2, R29.2, R30.2, R31.2, R32.2, R33.2, R34.2, T2.2 (E), T3.2 (S), T4.2 (E), T5.2 (S), TP4.1, U1.4 (GND), U2.1 (GND), U3.1 (GND_{P}), U3.5 (GND_{P}), U3.7 (GND_{P}), U3.10 (GND_{P}), U4.1 (GND_{P}), U4.5 (GND_{P}), U4.7 (GND_{P}), U4.10 (GND_{P}), U5.2 (~EN), U5.3 (GND), U5.7 (SPREAD), U5.9 (MS1/AD0), U5.10 (MS2/AD1), U5.13 (CLK), U5.18 (GND), U5.29 (GND), U6.2 (~EN), U6.3 (GND), U6.7 (SPREAD), U6.10 (MS2/AD1), U6.13 (CLK), U6.18 (GND), U6.29 (GND), U7.2 (~EN), U7.3 (GND), U7.7 (SPREAD), U7.9 (MS1/AD0), U7.13 (CLK), U7.18 (GND), U7.29 (GND)
I2C_SCL: H2.4 (I2C_SCL), H4.4 (I2C_SCL), M1.J1_4 (IO5/I2C_SCL), M4.2 (TX/SCL), R2.1, TP6.1, U3.2 (SCL_{2}), U4.2 (SCL_{2})
I2C_SDA: H2.3 (I2C_SDA), H4.3 (I2C_SDA), M1.J1_3 (IO4/I2C_SDA), M4.3 (RX/SDA), R1.1, TP5.1, U3.3 (SDA_{2}), U4.3 (SDA_{2})
unnamed: C6.2, U1.7 (SS)
unnamed: C7.1, U1.6 (BST)
unnamed: C7.2, L1.1, U1.5 (SW)
unnamed: C11.1, C12.1, C15.1, C16.1, FB2.2, R15.2, U3.11 (GND_{ISO}), U3.14 (GND_{ISO}), U3.16 (GND_{ISO}), U3.20 (GND_{ISO})
unnamed: C11.2, C15.2, FB1.2, U3.12 (V_{ISO})
unnamed: C12.2, C16.2, FB1.1, FB2.1, M2.1 (GND), M2.6 (VCC), R13.2, U3.17 (VDD_{ISO})
unnamed: C13.1, C14.1, C17.1, C18.1, FB4.2, R16.2, U4.11 (GND_{ISO}), U4.14 (GND_{ISO}), U4.16 (GND_{ISO}), U4.20 (GND_{ISO})
unnamed: C13.2, C17.2, FB3.2, U4.12 (V_{ISO})
unnamed: C14.2, C18.2, FB3.1, FB4.1, M3.1 (GND), M3.6 (VCC), R14.2, U4.17 (VDD_{ISO})
unnamed: C32.2, U5.8 (5VOUT)
unnamed: C33.2, U6.8 (5VOUT)
unnamed: C34.2, U7.8 (5VOUT)
unnamed: C35.1, U5.4 (CPO)
unnamed: C35.2, U5.5 (CPI)
unnamed: C36.1, U6.4 (CPO)
unnamed: C36.2, U6.5 (CPI)
unnamed: C37.1, U7.4 (CPO)
unnamed: C37.2, U7.5 (CPI)
unnamed: C38.1, U5.6 (VCP)
unnamed: C39.1, U6.6 (VCP)
unnamed: C40.1, U7.6 (VCP)
unnamed: D1.1 (C), F1.2, R3.2, T1.2 (S)
unnamed: D2.A, H3.2, T3.3 (D)
unnamed: D3.A, H5.2, T5.3 (D)
unnamed: DC1.12V, P1.1
unnamed: DC1.GND, P1.2
unnamed: F1.1, H1.1
unnamed: H6.3, U5.24 (OA1)
unnamed: H6.4, U5.21 (OA2)
unnamed: H6.5, U5.26 (OB1)
unnamed: H6.6, U5.1 (OB2)
unnamed: H7.3, U6.24 (OA1)
unnamed: H7.4, U6.21 (OA2)
unnamed: H7.5, U6.26 (OB1)
unnamed: H7.6, U6.1 (OB2)
unnamed: H8.3, U7.24 (OA1)
unnamed: H8.4, U7.21 (OA2)
unnamed: H8.5, U7.26 (OB1)
unnamed: H8.6, U7.1 (OB2)
unnamed: J3.G (GND), M2.4 (PGND)
unnamed: J3.S, M2.5 (PRB)
unnamed: J4.G (GND), M3.4 (PGND)
unnamed: J4.S, M3.5 (PRB)
unnamed: J5.G (GND), M4.4 (PGND)
unnamed: J5.S, M4.5 (PRB)
unnamed: M1.J3_6 (TX1/IO22), R6.1
unnamed: M2.2 (TX/SCL), U3.19 (SCL_{1})
unnamed: M2.3 (RX/SDA), U3.18 (SDA_{1})
unnamed: M3.2 (TX/SCL), U4.19 (SCL_{1})
unnamed: M3.3 (RX/SDA), U4.18 (SDA_{1})
unnamed: P2.1, PR2.1
unnamed: P2.2, PR2.2
unnamed: P2.3, PR2.3
unnamed: P2.4, PR2.4
unnamed: P3.1, P4.12V
unnamed: P3.2, P4.GND
unnamed: P5.1, PR6.1
unnamed: P5.2, PR6.2
unnamed: P5.3, PR6.3
unnamed: P5.4, PR6.4
unnamed: P6.1, V1.12V
unnamed: P6.2, V1.GND
unnamed: P7.1, P10.1
unnamed: P7.2, P10.2
unnamed: P7.3, P10.3
unnamed: P7.4, P10.4
unnamed: P7.5, P10.5
unnamed: P7.6, P10.6
unnamed: P8.1, P11.1
unnamed: P8.2, P11.2
unnamed: P8.3, P11.3
unnamed: P8.4, P11.4
unnamed: P8.5, P11.5
unnamed: P8.6, P11.6
unnamed: P9.1, P12.1
unnamed: P9.2, P12.2
unnamed: P9.3, P12.3
unnamed: P9.4, P12.4
unnamed: P9.5, P12.5
unnamed: P9.6, P12.6
unnamed: PR4.G, PR4.S
unnamed: R3.1, R4.2, T1.1 (G)
unnamed: R9.2, T2.1 (B)
unnamed: R8.2, R10.2, T2.3 (C), T3.1 (G)
unnamed: R13.1, R15.1, U3.13 (VSEL)
unnamed: R14.1, R16.1, U4.13 (VSEL)
unnamed: R17.2, R19.2, T4.3 (C), T5.1 (G)
unnamed: R18.2, T4.1 (B)
unnamed: R20.2, U5.14 (~PD/UART)
unnamed: R21.2, U6.14 (~PD/UART)
unnamed: R22.2, U7.14 (~PD/UART)
unnamed: R23.2, R24.1, U5.17 (VREF)
unnamed: R25.2, R26.1, U6.17 (VREF)
unnamed: R27.2, R28.1, U7.17 (VREF)
unnamed: R29.1, U5.23 (BRA)
unnamed: R30.1, U5.27 (BRB)
unnamed: R31.1, U6.23 (BRA)
unnamed: R32.1, U6.27 (BRB)
unnamed: R33.1, U7.23 (BRA)
unnamed: R34.1, U7.27 (BRB)
PUMP_MAIN: M1.J1_10 (IO10), R8.1
STEP_BUS: M1.J3_7 (RX1/IO21), R6.2, R20.1, R21.1, R22.1
STEP_NUT_A: M1.J3_4 (IO15), U6.16 (STEP)
STEP_NUT_B: M1.J3_9 (IO19), U7.16 (STEP)
STEP_PH_DN: M1.J1_11 (IO11), U5.16 (STEP)
US_ECHO: J1.3, M1.J1_13 (IO3/ADC3)
US_TRIG: J1.2, M1.J1_6 (IO7/SPI_MOSI)

Notes on the sheet:
pH Sensor
5V→3.3V 1A LDO
Nutition Pump B
Safety Switches
Nutition Pump A
Bulk for radio TX
POWER TRAIN
Stay off during SoC reset
Reverse polarity protection
Water Temperature Sensor
Electro Conductiviy Sensor
Bootstrap
5V→3.3V 0.8A LDO
Environmental Sensor (optional)
PUMP & VALVE DRIVERS
5ms soft-start
Transient voltage stabilizer
12V→5V 3A BUCK
SoC
I2C SENSORS
PERISTALTIC PUMP DRIVERS
TEST POINTS
Bulk for motor surge
Light Sensor (optional)
Ph↓ Pump
ATO Valve
WATER LEVEL SENSOR/SWITCHES
Prevent high-frequency oscillation
Noise mitigation
Main Pump
Water Height Sensor
Flyback
