cvonk/OPNhydroponics/hardware/kicad/hydroponics-controller.kicad_sch

## KiCad design hardware/kicad/hydroponics-controller.kicad_sch (2026-02-11)

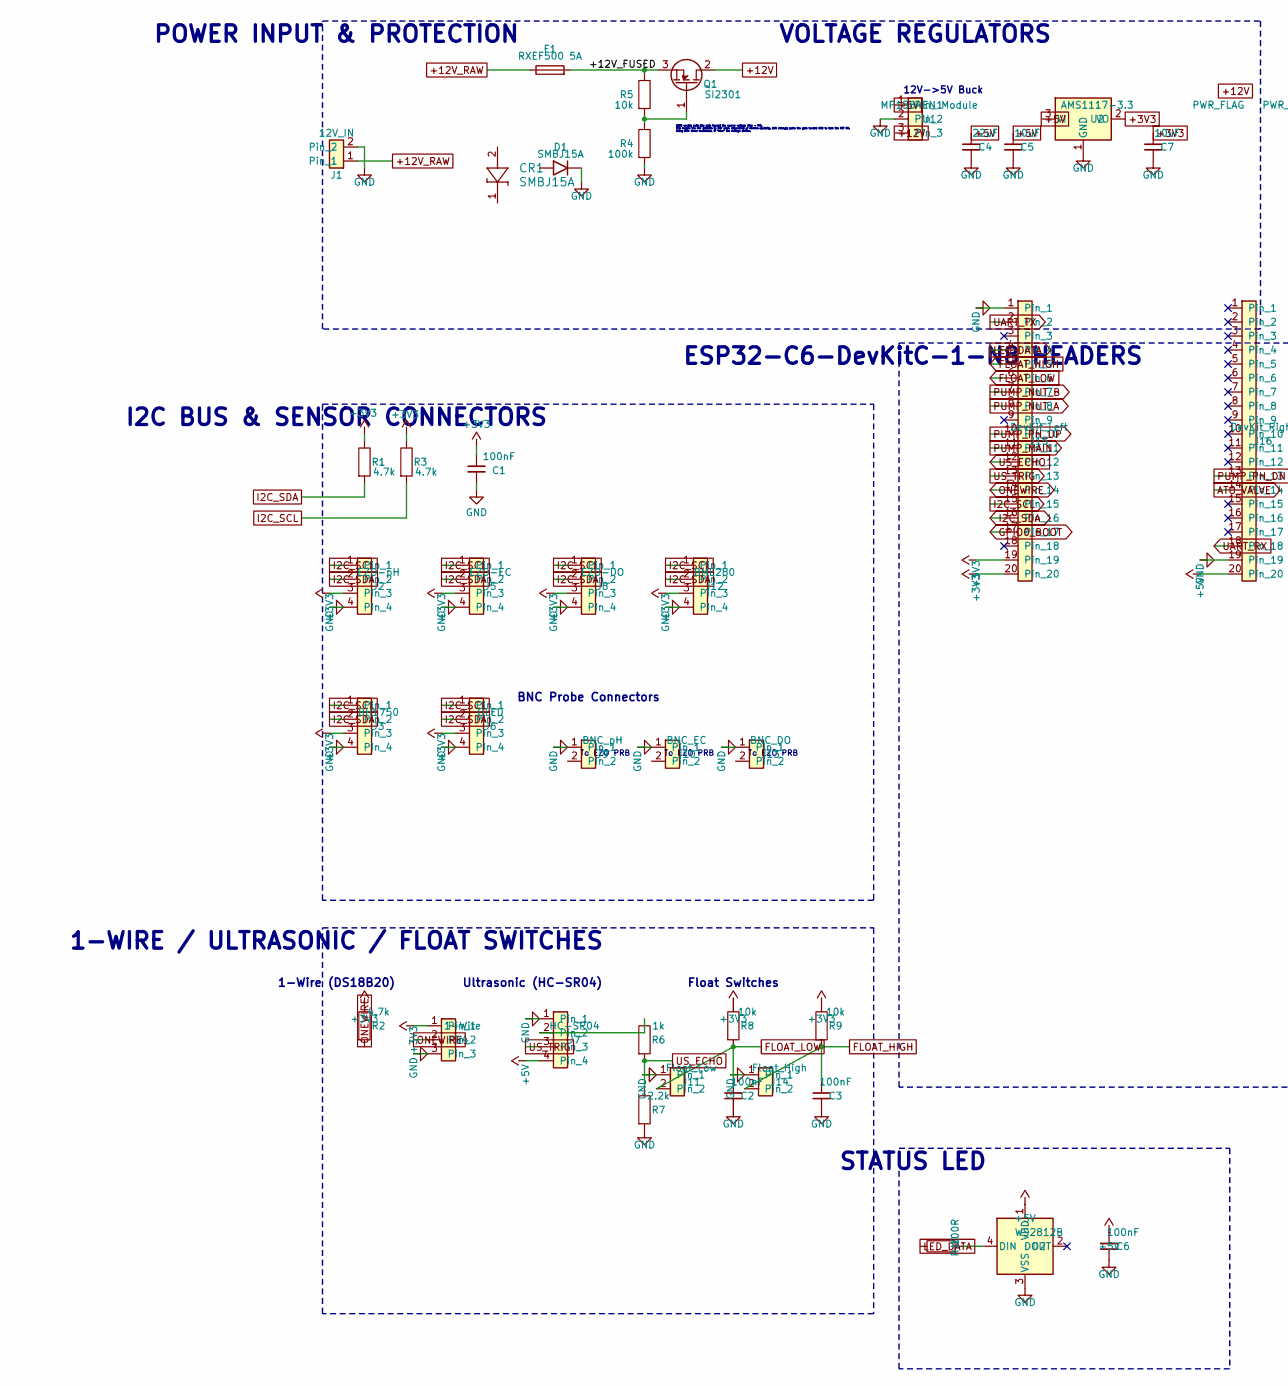
[picture p3: schematic hydroponics-controller.kicad_sch, part in row 1, column 1]

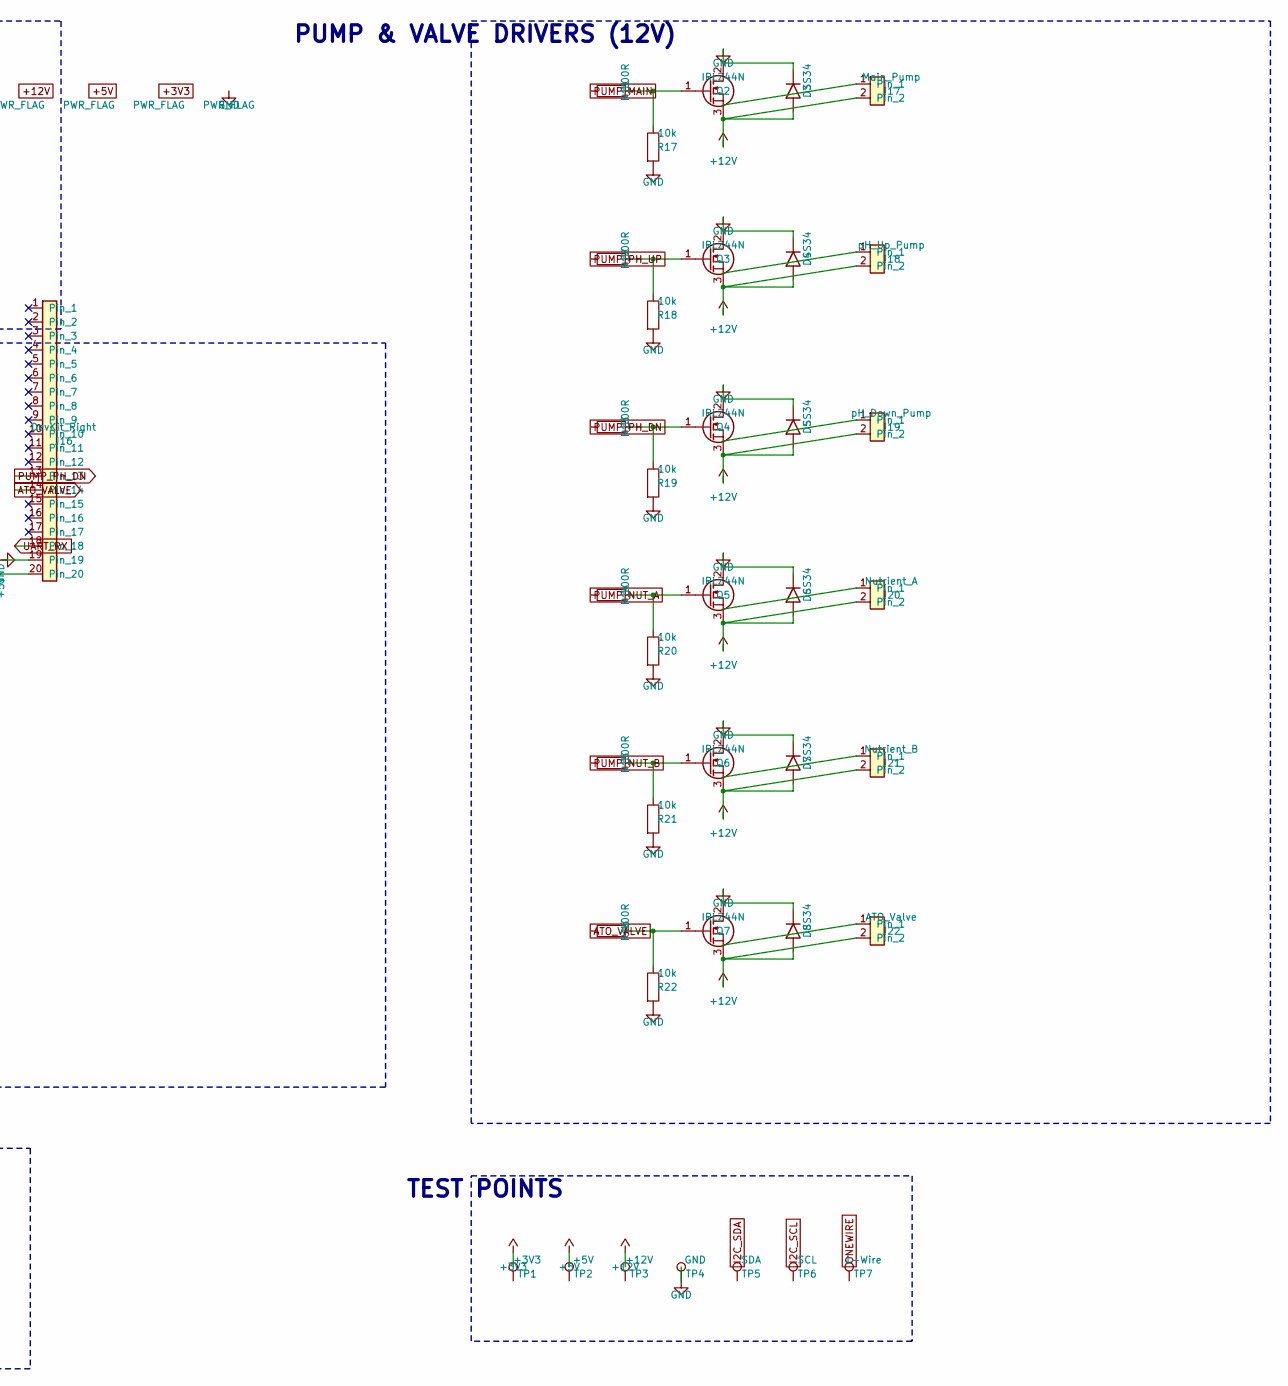
[picture p4: schematic hydroponics-controller.kicad_sch, part in row 1, column 2]

Parts:
C1, C2, C3, C6: 100nF; C_0805_2012Metric
C4: 22uF; C_0805_2012Metric
C5, C7: 10uF; C_0805_2012Metric
CR1: SMBJ15A; DO-214AASMB_J-BEND_LTF
D1: SMBJ15A; D_SMB_Handsoldering
D2: WS2812B; LED_WS2812B_PLCC4_5.0x5.0mm_P3.2mm
D3, D4, D5, D6, D7, D8: SS34; D_SMA_Handsoldering
F1: RXEF500 5A; Fuse_1812_4532Metric
J1: 12V_IN; PhoenixContact_MSTBA_2,5_2-G-5,08_1x02_P5.08mm_Horizontal
J2: EZO-pH; JST_PH_B4B-PH-K_1x04_P2.00mm_Vertical
J3: BH1750; JST_PH_B4B-PH-K_1x04_P2.00mm_Vertical
J4: 1-Wire; JST_PH_B3B-PH-K_1x03_P2.00mm_Vertical
J5: EZO-EC; JST_PH_B4B-PH-K_1x04_P2.00mm_Vertical
J6: OLED; JST_PH_B4B-PH-K_1x04_P2.00mm_Vertical
J7: HC-SR04; JST_XH_B4B-XH-A_1x04_P2.50mm_Vertical
J8: EZO-DO; JST_PH_B4B-PH-K_1x04_P2.00mm_Vertical
J9: BNC_pH; BNC_TEConnectivity_1478204_Vertical
J10: BNC_EC; BNC_TEConnectivity_1478204_Vertical
J11: Float_Low; JST_XH_B2B-XH-A_1x02_P2.50mm_Vertical
J12: BME280; JST_PH_B4B-PH-K_1x04_P2.00mm_Vertical
J13: BNC_DO; BNC_TEConnectivity_1478204_Vertical
J14: Float_High; JST_XH_B2B-XH-A_1x02_P2.50mm_Vertical
J15: DevKit_Left; PinHeader_1x20_P2.54mm_Vertical
J16: DevKit_Right; PinHeader_1x20_P2.54mm_Vertical
J17: Main_Pump; PhoenixContact_MSTBA_2,5_2-G-5,08_1x02_P5.08mm_Horizontal
J18: pH_Up_Pump; PhoenixContact_MSTBA_2,5_2-G-5,08_1x02_P5.08mm_Horizontal
J19: pH_Down_Pump; PhoenixContact_MSTBA_2,5_2-G-5,08_1x02_P5.08mm_Horizontal
J20: Nutrient_A; PhoenixContact_MSTBA_2,5_2-G-5,08_1x02_P5.08mm_Horizontal
J21: Nutrient_B; PhoenixContact_MSTBA_2,5_2-G-5,08_1x02_P5.08mm_Horizontal
J22: ATO_Valve; PhoenixContact_MSTBA_2,5_2-G-5,08_1x02_P5.08mm_Horizontal
Q1: SI2301; SOT-23
Q2, Q3, Q4, Q5, Q6, Q7: IRLZ44N; TO-220-3_Vertical
R1, R2, R3: 4.7k; R_0805_2012Metric
R4: 100k; R_0805_2012Metric
R5, R8, R9, R17, R18, R19, R20, R21, R22: 10k; R_0805_2012Metric
R6: 1k; R_0805_2012Metric
R7: 2.2k; R_0805_2012Metric
R10, R11, R12, R13, R14, R15, R16: 100R; R_0805_2012Metric
TP1: +3V3; TestPoint_Pad_1.0x1.0mm
TP2: +5V; TestPoint_Pad_1.0x1.0mm
TP3: +12V; TestPoint_Pad_1.0x1.0mm
TP4: GND; TestPoint_Pad_1.0x1.0mm
TP5: SDA; TestPoint_Pad_1.0x1.0mm
TP6: SCL; TestPoint_Pad_1.0x1.0mm
TP7: 1-Wire; TestPoint_Pad_1.0x1.0mm
U1: MP1584EN Module
U2: AMS1117-3.3; SOT-223-3_TabPin2

Connections:
+3V3: C1.1, C7.1, J2.3, J3.3, J4.1, J5.3, J6.3, J8.3, J12.3, J15.19, J15.20, R1.1, R2.1, R3.1, R8.1, R9.1, U2.2 (VO)
+5V: C4.1, C5.1, C6.1, D2.1 (VDD), J7.4, J16.20, U1.1, U2.3 (VI)
+12V: D3.1 (K), D4.1 (K), D5.1 (K), D6.1 (K), D7.1 (K), D8.1 (K), J17.2, J18.2, J19.2, J20.2, J21.2, J22.2, Q1.2 (S), Q2.3 (S), Q3.3 (S), Q4.3 (S), Q5.3 (S), Q6.3 (S), Q7.3 (S), U1.3
+12V_FUSED: F1.2, Q1.3 (D), R5.1
+12V_RAW: F1.1, J1.1
ATO_VALVE: J16.14, R16.1
FLOAT_HIGH: C3.1, J14.2, J15.5, R9.2
FLOAT_LOW: C2.1, J11.2, J15.6, R8.2
GND: C1.2, C2.2, C3.2, C4.2, C5.2, C6.2, C7.2, D1.2 (A2), D2.3 (VSS), D3.2 (A), D4.2 (A), D5.2 (A), D6.2 (A), D7.2 (A), D8.2 (A), J1.2, J2.4, J3.4, J4.3, J5.4, J6.4, J7.1, J8.4, J9.1, J10.1, J11.1, J12.4, J13.1, J14.1, J15.1, J16.19, Q2.2 (D), Q3.2 (D), Q4.2 (D), Q5.2 (D), Q6.2 (D), Q7.2 (D), R4.2, R7.2, R17.2, R18.2, R19.2, R20.2, R21.2, R22.2, TP4.1, U1.2, U2.1 (GND)
GPIO0_BOOT: J15.17
I2C_SCL: J2.1, J3.1, J5.1, J6.1, J8.1, J12.1, J15.15, R3.2
I2C_SDA: J2.2, J3.2, J5.2, J6.2, J8.2, J12.2, J15.16, R1.2
LED_DATA: J15.4, R10.1
unnamed: D2.4 (DIN), R10.2
unnamed: J7.2, R6.1
unnamed: Q1.1 (G), R4.1, R5.2
unnamed: Q2.1 (G), R11.2, R17.1
unnamed: Q3.1 (G), R12.2, R18.1
unnamed: Q4.1 (G), R13.2, R19.1
unnamed: Q5.1 (G), R14.2, R20.1
unnamed: Q6.1 (G), R15.2, R21.1
unnamed: Q7.1 (G), R16.2, R22.1
ONEWIRE: J4.2, J15.14, R2.2
PUMP_MAIN: J15.11, R11.1
PUMP_NUT_A: J15.8, R14.1
PUMP_NUT_B: J15.7, R15.1
PUMP_PH_DN: J16.13, R13.1
PUMP_PH_UP: J15.10, R12.1
UART_RX: J16.18
UART_TX: J15.2
US_ECHO: J15.12, R6.2, R7.1
US_TRIG: J7.3, J15.13

Notes on the sheet:
POWER INPUT & PROTECTION
VOLTAGE REGULATORS
12V->5V Buck
ESP32-C6-DevKitC-1-N8 HEADERS
I2C BUS & SENSOR CONNECTORS
BNC Probe Connectors
To EZO PRB
1-WIRE / ULTRASONIC / FLOAT SWITCHES
1-Wire (DS18B20)
Ultrasonic (HC-SR04)
Float Switches
PUMP & VALVE DRIVERS (12V)
STATUS LED
TEST POINTS
100k weakly pulls the gate toward the source voltage (Vgs → 0V). This means the FET defaults to OFF when unpowered or reverse-polarity. 10k strongly pulls the gate toward GND to turn the FET ON. Being 10× lower resistance, it "wins" the voltage divider.
