cvonk/OPNhydroponics/(commit log)

2026-02-24 update design and schematic
    [OPNhydro_r1.kicad_sch]
2026-02-25 add pump ctrl and power buffers
    [OPNhydro_r1.kicad_sch]
2026-02-27 update w design and schematic
    [OPNhydro_r1.kicad_sch]
2026-03-01 fix ERC errs
    [OPNhydro_r1.kicad_sch]
2026-03-03 ùpdate
    [OPNhydro_r1.kicad_sch]
2026-03-04 moving to stepper motors. schematic not yet. mark down already.
    [OPNhydro_r1 BOM.csv, OPNhydro_r1.kicad_sch]
2026-03-04 move to step motors for the peristaltic pumps
    [OPNhydro_r2.kicad_pcb, OPNhydro_r2.kicad_sch]
2026-03-04 tweak layout
    [OPNhydro_r2.kicad_sch]
